OsubuDc/Thesis/README.md

# Thesis
Adaptive impedance control of a 1-DoF series elastic actuator in contact-rich tasks using reinforcement learning.
