OsubuDc/Thesis/VSCODE_LaTex/main.tex

\documentclass{article}

\usepackage[
  backend=biber,
  style=ieee
]{biblatex}

\addbibresource{/home/oskar/Thesis/VSCODE_LaTex/ThesisReferences.bib} % relatieve pad

\begin{document}

Hier citeer ik de paper van Shim \cite{shimDisturbanceObserver2020}.

\printbibliography

\end{document}
