OsubuDc/Thesis/ThesisV2/ThesisV2_main.pdf

KU Leuven

Faculty of Engineering Technology

# Implementation of a novel compliant

# transmission in a 3 DoF robotic

# testbench for collaborative hand

# guiding tasks

## Oskar De Clerck

A thesis submitted for the degree of Master of Science in industriële wetenschappen: Elektromechanica

Academic Year 2025–2026

Promotor: ir. Maurizio Grossi Copromotor: prof. dr. ir. Dino Accoto

# Abstract

i

ii

# Acknowledgements

iii

iv

# Contents

Abstract | i
Acknowledgements | iii
Nomenclature | xi
1 Introduction | 1
2 Literature Review | 11
3 Methodology | 25

v

Contents

4 Validation and Results | 27
5 Conclusion and Future Work | 29
References | 31
2D Manufacturing Drawings | 35
Additional Experimental Results | 37
Source Code | 39

vi

# List of Figures

1.1 Human, robot, and shared workspace from Fraunhofer [6] | | 3
1.2 Levels of cooperation between human worker and robot from Fraunhofer [6]. . | 3
1.3 3ARM manipulator [19] | | 7
1.4 Gas spring characteristic by Suspa [20] | | 7
1.5 Spring balancer from Transprotec [21] | | 8
1.6 IAD integrated in an assembly line [24] | | 8
2.1 Impedance control for robotic structure in contact with an environment [25]. | 12
2.2 Mass–spring–damper system in contact with external force fe [25] | | 12
2.3 General classification of the impedance control approaches [25] | | 13

2.4 Impedance control diagram, with reference position xr, external force fr which
in theory can be canceled, and a measured position x [25] | 15

2.5 Admittance control diagram, with reference position xr, compliant reference
position xc, measured position x, and measured external force fe [25] | | 15
2.6 Mass–spring–damper system with commanded position xc [25] | | 17
2.7 Motor and load connected with a rigid shaft | | 18
2.8 Motor and load connected with a compliant coupling | | 18
2.9 General SEA schematic reconstructed from [29] | | 19
2.10 Vector diagram reconstructed from [29] | | 22
2.11 Torque control diagram with feedforward terms from [29] | | 23
2.12 Torque control diagram from [30] | | 24

vii

List of Figures

viii

# List of Tables

4.1 Example results table | 27

ix

List of Tables

x

# Nomenclature

## Symbols

q | Joint position vector | [rad]
Ks | Spring stiffness | [Nm/rad]

## Abbreviations

CAN | Controller Area Network
SET | Series Elastic Transmission

xi

List of Tables

xii

# Chapter 1

# Introduction

## 1.1 Background and Motivation

### 1.1.1 Musculoskeletal disorders and ergonomic work environments

Non-ergonomic work environments place strain on the human body, which can cause painful complications and limit the worker’s ability to perform tasks optimally. Ergonomics can be defined as the study of work, where the goal is to fit tasks and jobs to workers’ capabilities, rather than forcing workers to adapt to the job. An ergonomic work environment therefore implements task-specific strategies to prevent reduced work ability. How these complications arise, which parts of the body are affected, and how they can be prevented are explained in this section.
The musculoskeletal system contains muscles, bones, joints and connective tissues like tendons and ligaments. Musculoskeletal disorders (MSDs) can therefore be defined as injuries of the

muscles, nerves, tendons, joints, cartilage, and spinal discs. When these injuries are sustained or worsened by exposure to risk factors in the workplace, they are also known as work-related musculoskeletal disorders (WMSDs). These disorders can go from minor aches to severe

pain and chronic illness requiring medical treatment, potentially preventing workers from performing physical tasks.
WMSDs develop over time due to non-ergonomic working conditions and can be categorized into two main groups:
- Back disorders related to handling loads
- Upper limb disorders, also known as repetitive strain injuries (RSIs)

MSDs can be caused by, for example:

- Twisting and bending movements while handling loads
- Repetitive or forceful movements
- Awkward and static postures
- Exposure to vibrating tools
- Prolonged sitting or standing in the same position

Chapter 1. Introduction

An increase in MSDs has been reported worldwide. This rise is partly attributed to improved recognition and reporting, but also to the tendency for work to be more segmented and specialized. This trend is driven by an increasingly competitive global economy, where fast-paced repetitive work environments are more widespread.

### 1.1.2 Industrial motivation for ergonomic improvement

Musculoskeletal disorders affect approximately one in three people worldwide. Within the European Union, MSDs represent the most costly health-related problems, affecting 45 million workers. Many individuals are unable to continue working beyond the age of 60 due to these conditions, resulting in billions of euros in lost revenue and a substantial burden on the public healthcare system.

A declining physical condition can also lead to mental health issues such as depression or frustration, resulting in reduced job satisfaction and, indirectly, lower work performance, even when workers are still physically able to continue working.

The increase in education in the workforce, combined with higher expectations regarding job satisfaction, has reduced workers’ tolerance for WMSDs. An ergonomic work environment can prevent the development of WMSDs and directly reduce both the cost to companies due to sick leave and the societal impact.

Reduced work ability can be categorized into absenteeism and presenteeism. Absenteeism refers to the absence from work due to injuries sustained on the job. Presenteeism describes the situation in which workers continue to attend their expected work duties despite existing injuries, often due to concerns about job security. In such cases, work is performed in a self–protective manner to reduce physical strain.

In Belgium, 2.5 million people were affected by MSDs in 2018 (approximately 62% of the Belgian working population in 2015), resulting in 3 billion euros in direct medical costs and 2 billion in work absenteeism, corresponding to 0.3% of Belgium’s gross domestic product [1][2][3][4][5].

### 1.1.3 Physical human–robot interaction

There is a clear need to address reduced work efficiency resulting from physical injuries since this improves the quality of life of an increasingly older workforce, while also reducing the impact on social welfare systems and increasing overall economic productivity. Industry has already adopted robotic solutions to achieve accuracy, speed, and repeatability that human workers cannot provide. Humans, however, provide flexibility and have the capability to react to unforeseen circumstances. By increasing the degree of human participation, the strength and repeatability of robots are combined with the adaptability and decision–making skills of humans. Humans and robots each operate in their respective workspaces to perform their tasks, and in some cases share the same workspace, as illustrated in Figure 1.1.

1.1. Background and Motivation


Figure 1.1: Human, robot, and shared workspace from Fraunhofer [6].

Human–robot cooperation generally refers to the use of robots without safety fencing, also called cage–free robots. This is in contrast to traditional robots which are stiff, heavy, and lack safety features that allow them to operate in the same space as humans, and are consequently only allowed to operate in closed –off workspaces.

Humans and robots can work together in different types of operation, as illustrated in Figure 1.2.


Figure 1.2: Levels of cooperation between human worker and robot from Fraunhofer [6].

From left to right an increasing level of interaction is shown.

- Cell: Robot operates in traditional cage, fenced–off from human contact
- Coexistence: Human and cage–free robot work at the same time, but in different workspaces
- Synchronized: Humans and cage–free robots work in the same workspace, but one at a time
- Cooperation: Human and cage–free robot have tasks in the same workspace at the same time, but do not work together on the same task

Chapter 1. Introduction

- Collaboration: Human and cage–free robot work in the same workspace on the same task

The robotic testbench developed in this thesis operates in collaboration mode during assisted load handling, when the human operator physically guides the robotic arm, and in coexistence mode during the floating stand–by state, when no physical interaction is taking place. This distinction is further clarified in chapter (idk exactly for now).

Collaborative robots, defined as robots capable of performing collaborative tasks as described above, are widely used in industry. However, they are still primarily applied in traditional robotic operations such as pick–and–place tasks. In many cases, humans and robots remain either physically separated or operate in a coexistence mode, where no physical barrier is present but no direct interaction takes place. Such implementations are only economically viable for large batch sizes, since a whole production line needs to be tuned towards that specific robotic solution.
Cage–free robotic arms that share a workspace with a human worker are introduced to increase production flexibility. Interactive robotic solutions for small batches and varying product sizes have become a clear need since 70% of collaboration between human workers and robots occurs in assembly applications. An industry survey reported that 86% of respondents were willing

to invest in robotic solutions, indicating strong industrial interest. The primary motivations for introducing robotic arms in assembly environments are:

- Improving operational efficiency
- Improving ergonomics

Cage–free robotic solutions generally involve higher initial costs compared to traditional fenced systems due to safety certification requirements and conformity procedures to minimize the risk of injuries. However, companies are often willing to accept longer payback periods for implementing and testing company–specific robotic solutions which increase ergonomics [6][7]. ISO/TS 15066 covers the safety requirements for collaborative operations between human

workers and robots. This normative classifies four different collaborative operations modes [8][9]:

- Safety–rated monitored stop
- Hand guiding
- Power and force limiting
- Speed and separation monitoring

Safety–rated monitored stop

The robot operates at its rated speed when a human is not present in the collaborative workspace. When a human enters the workspace, which can be detected by various means like laser scanners or light curtains, the robot undergoes a complete stop. As long as the human is in the workspace, the robot will not operate. Only by leaving the workspace and resetting the safety stop, can operation continue.

1.1. Background and Motivation

Hand guiding

Hand guided robotic applications are defined as a direct physical interaction between humans and robots, where the human operator has full control over the robot’s motion. In this approach, a direct input device is located at or near the end–effector to measure input forces and simultaneously define the position of the human in the shared workspace. The robot must be in a monitored stop before hand guiding can be activated via an enabling device. Safety requirements for this mode include force and/or torque sensing at the guiding point,

emergency stop accessible from the position where the robot is being guided, which is typically at the end–effector, and a maximum speed limit during guided motion.

Power and force limiting

This mode is the most commonly associated with collaborative robots. The robot’s software and hardware are designed in such a way that any contact with a human cannot result in injury. Low robot mass, rounded surfaces, and padding are combined with active force and torque sensing, which limits contact forces with the environment below defined thresholds depending on the body region of the human that can be in contact with the robot.

Speed and separation monitoring

Robots and humans can operate in the same workspace at the same time, but the position and speed of the human and robot relative to each other is constantly monitored to adjust the speed of the robot with the goal of constantly having a minimum dynamical separation distance at all times.

Hand guiding is useful for packaging and assembly applications since it combines the physical strength of robotic arms, which can compensate for the weight of components or help with move relatively light but large components, with human intelligence.
ISO/TS 15066 specifies that the hand–guiding devices should be located at or near the robot

end–effector, structurally restricting compliant interaction to a single designated contact point. Collisions or attempted handling of the robotic arm elsewhere will result in a safety stop [10].

Existing robotic solutions that allow a human worker to hand guide a robotic arm while simultaneously identifying and compensating for payloads of unknown variable weights, without requiring prior software configuration, are to the best of the author’s knowledge, not available in assembly and packaging industries. When hand guiding is discussed in literature, it is typically limited to sensorized end–effectors on conventional stiff robots. Collaborative robots adopted in industry generally lack build–in compliance. As previously stated, collaborative robots are used for applications with little to no human contact, where precision and repeatability is more important than inherent compliance [11][12].

This absence in current industrial applications is further supported by surveys of end users, system integrators and researchers, which indicate that collaborative robots are still primarily used as conventional stiff robots with limited or no direct human interaction, while offering the added value of less space requirements for operation [13].

Chapter 1. Introduction

Current collaborative robots with the highest payloads, such as the UR30 from Universal Robots and the CR-35iB from FANUC, can handle loads up to 30kg and 50kg respectively. Still, hand guiding is mainly used for point– and path–based teaching and not for weight compensation tasks in hand guiding applications. The user can intuitively move the robot to a new point in space and record that position. This can be done for a single point or for a full path; in this case the robot records the continuous movement while a button is pressed. It is, however, possible to correctly configure collaborative robots for weight compensation, but software is required for correct calibration of the load attached to the end–effector. Although rare, some collaborative robots can estimate payload weight and center of mass by performing predefined controlled motions, but multiple interactions with the software controller are needed, making this approach time–consuming. This method is not generally available, and is often part of an optional software package that is not compatible with every collaborative robot. This confirms that automatic real–time payload identification without software interaction is not a standard feature of current collaborative platforms deployed in assembly and packaging contexts industries, representing a key limitation addressed by this thesis [14][15][16][17].

### 1.1.4 Weight assisting devices

Passive weight compensating manipulators are well established in industrial environments to help human workers perform their tasks in a more ergonomically sustainable way. These devices, if well calibrated, allow payloads to be moved around with minimal effort, offering passive, purely mechanically sourced weight compensation, effectively combining software–free and intuitive use. These manipulators however share a fundamental limitation; they only operate efficiently only within a pre-tuned weight range. The further a payload differs from the equilibrium point, the more force the human operator will have to deliver to move the load fixed to the manipulator. As a direct consequence, varying payloads that are too different in weight cannot be manipulated with these devices without manually re–tuning the counter–force system, for example counterweights and gas springs [18]. The proposed system replicates the

intuitive, software–free interaction properties of a passive balancer, while adding real–time load identification and the possibility to perform autonomous tasks, integrating this solution into the production line. Some commercially available examples support this claim.

1.1. Background and Motivation

The company 3ARM produces commercially available weight compensating manipulators, an example of which shown in Figure 1.3. Pneumatic gas springs are used to compensate weights within a minimum and maximum payload limit. The gas springs can be manually tuned to compensate for different weight classes [19]. Figure 1.4 presents an example of a gas

spring characteristic. By adjusting the filling pressure, the spring can optimized for different payloads scenarios [20].

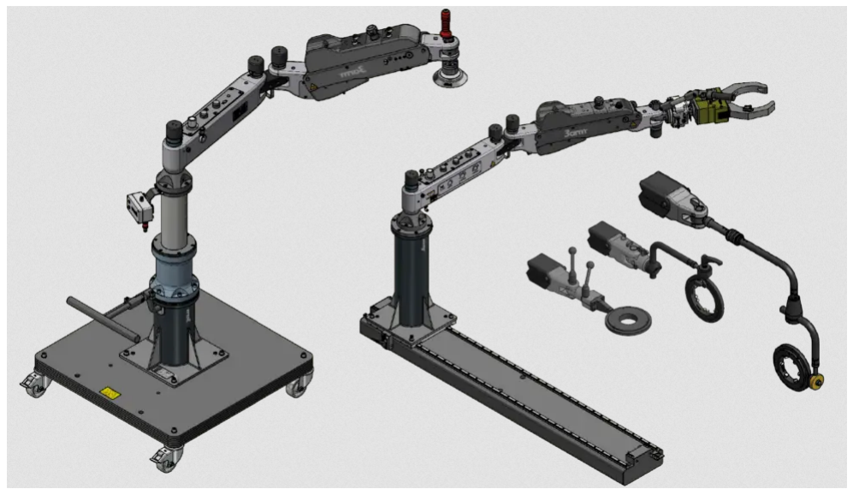
[picture p92: figure]

Figure 1.3: 3ARM manipulator [19].


Figure 1.4: Gas spring characteristic by Suspa [20].

Chapter 1. Introduction

Transprotec offers spring balancers, showh in Figure 1.6, that are tuned to a specific weight, load changes are not permitted to guarantee safety and correct operation [21].

Figure 1.5: Spring balancer from Transprotec [21].

### 1.1.5 Intelligent Assist Devices

The robotic testbench proposed in this thesis belongs to the category of Intelligent Assist Devices (IADs). These are described as computer–controlled, servo–driven tools that enable

human workers to manipulate payloads in a safe and ergonomic way. This differentiates IADs from the devices described in Section 1.1.4, which were completely passive. IADs were

introduced to increase productivity and mitigate non–ergonomic work environments, a major issue in societies with an aging workforce. Currently, the term IADs is not commonly used anymore, as it has been subsumed under the modern term collaborative robots [22]. When

IADs are mentioned today, they primarily appear as overhead gantry–mounted installations. While IADs can be effective in dedicated production cells with sufficient overhead clearance, they are unsuitable for industrial environments where ceiling height is limited, or overhead obstructions are present.
IADs cannot only interact safely and compliantly with human operators, but can also actively follow a predefined path. An example of this semi–autonomous strategy can be found in the

automotive industry, where the controller guides the payload along a moving assembly line so that the human operator can focus on correctly installing the part into the assembly, rather than continuously repositioning the payload, as shown in Figure 1.6[23][24].

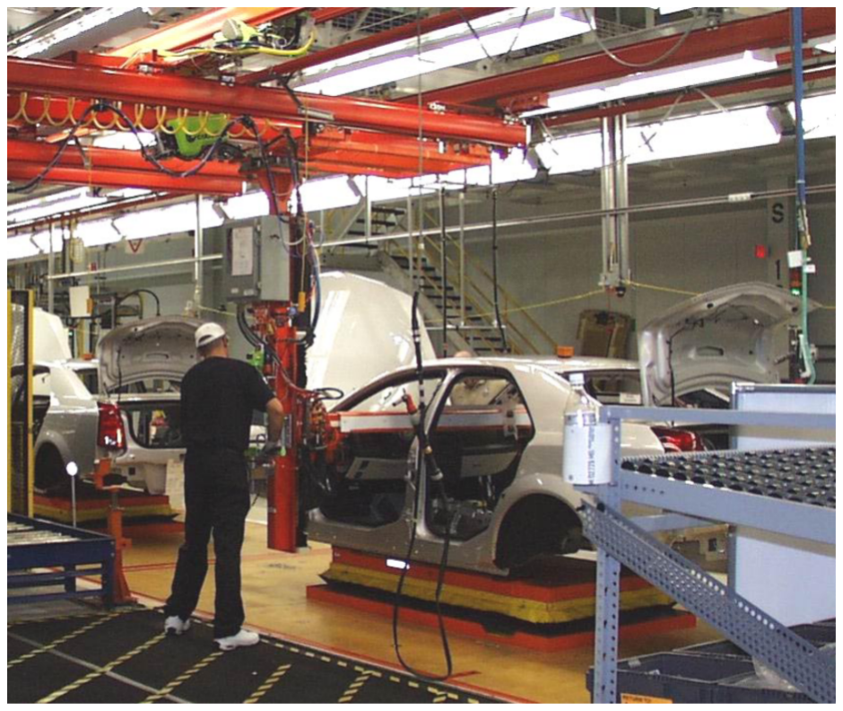
[picture p93: figure]

Figure 1.6: IAD integrated in an assembly line [24].

1.2. Problem Statement

## 1.2 Problem Statement

Non–ergonomic load handling is the primary cause of musculoskeletal disorders in packaging and assembly industries. Passive weight compensating devices are well established in industry with the goal of reducing this physical strain on the human body; these devices however cannot adapt to varying payloads and provide no sensing, intelligence, or active integration with production lines.
Intelligent assist devices offer semi–autonomous advantages to support payload manipulation. Gantry–style implementation cannot be used in buildings with limited ceiling heights or overhead obstructions. IADs are semi–autonomous solutions and can thus offer a higher degree of integration than passive devices.
Collaborative robots require frequent software interaction to calibrate the system for different payloads or work modes. Although rare, it is possible for specific collaborative robots to go through predefined motions to estimate the weight of a payload rigidly attached to the end–effector, which also requires software programming and confirmation. Payloads also need to be fixed to the end–effector, which is not always possible for loads that vary in shape and size.
This thesis presents a three degree of freedom robotic testbench using novel, inherently compliant transmissions. This allows for the combination of an intrinsically safe design with real–time weight measurements and intuitive, software–free hand guidance at any point along the arm structure. This approach aims to combines the strengths of collaborative robots with passive or intelligent assist devices.
The testbench provides a weight–optimized platform that allows for further validation of the novel transmission, offering data acquisition and a configurable controller written in C++ specifically for the approach of this thesis.

## 1.3 Thesis Outline

In Chapter 2, the theoretical background on concepts relevant to this thesis is introduced, followed by an overview of the current state of the art in collaborative load–handling systems.

In Chapter 3, the design of the robotic testbench is presented; this includes the mechanical design, hardware implementation, proposed controller, and data communication architecture.

In Chapter 4, the developed testbench and proposed controller are experimentally validated; this includes mechanical design validation and controller performance evaluation in interactive load–handling experiments.

Chapter 5 summarizes the main conclusions of this thesis, discusses limitations of the proposed system, and presents possible improvements for future development.

Chapter 1. Introduction

# Chapter 2

# Literature Review

## 2.1 Theoretical Background

### 2.1.1 Impedance control

Impedance control is widely used in applications that involve physical human–robot interaction. The interaction forces between the robotic structure and its environment can be regulated by adjusting the apparent mechanical impedance of the robot. Mechanical impedance is defined as the ratio of the output force to the input velocity. It represents how much the robotic structure resists motion when an external force is applied.

Z(s) = F(s)
v(s)

(2.1)

Its inverse, mechanical admittance is defined as the ratio of input velocity to the output force.

Y (s) = v(s)
F(s)

=

1
Z(s)

(2.2)

When two mechanical bodies interact, the interaction can be characterized by their relative mechanical properties. A body that resists motion by responding to displacement with forces is modelled as a mechanical impedance. A body that responds to forces by generating motion or deformation is modelled as a mechanical admittance. These roles are not inherent properties of the objects themselves, but a consequence of the mechanical properties of the interacting bodies relative to each other, and the choice of input and output signals.
In conventional robotic applications, the robotic structure is stiff, position–controlled, and has a high inertia compared to its environment, like a human worker or payloads. It follows a defined trajectory and resists external forces; in this scenario, the robotic structure behaves as an impedance. The environment, whether it is a workpiece, or a human worker, yields to externally applied forces and is typically modelled as an admittance. As an example, pushing a trolley or compressing a pillow by applying an external force can clarify this concept; in both cases the environment moves or deforms in response to an applied force.
The impedance or admittance assignment is context–dependent. A rigid concrete wall presents an impedance that is much higher than that of a lightweight robotic structure; from the perspective of the robotic structure, it must yield to its much stiffer environment.

Chapter 2. Literature Review

A human operator physically guiding a robotic arm applies forces and expects the robotic

structure to move; the human worker behaves like an impedance, while the robotic structure behaves like an admittance. Impedance control modifies the mechanical impedance of a robotic structure to control how it behaves relative to its environment.

Figure 2.1 illustrates a stiff robotic structure interacting with its environment. The schematic at the end–effector demonstrates how impedance control can modify the apparent impedance.


Figure 2.1: Impedance control for robotic structure in contact with an environment [25].

Impedance control mirrors the ability of the human body to change its mechanical impedance by tensioning its muscles. To guarantee safe interaction between a robotic structure and its environment, one of the two bodies should be compliant relative to the other. Most collaborative robots lack the ability to dynamically change their mechanical impedance; therefore, safe interaction between between a robot and an unknown environment cannot be guaranteed by mechanical design alone. Impedance control allows for a user–defined, dynamic relationship between the trajectory of the end–effector and the contact forces from the environment, allowing stiff robotic structures to compliantly react to their environment.


Figure 2.2: Mass–spring–damper system in contact with external force fe [25].

The mathematical derivation for impedance control starts by considering a second–order system as shown in Figure 2.2.

m x¨ + b x˙ + k x = u + fe | (2.3)

In this equation, m represents the system mass, b the damping coefficient, k the stiffness coefficient, u the control input (as seen from the plant’s perspective) generated by the controller

which is applied to the plant dynamics, and fe is the external force applied to the system.

2.1. Theoretical Background

The position x = xe represents the position of the contact surface and can be interpreted as the position error relative to the equilibrium position xr.
As stated before, the idea of impedance control is to change the apparent impedance of a mechanical system. By defining a target impedance, the mechanical impedance of the system can be modified. This target impedance is expressed as a virtual mass–spring–damper system:
md (ẍ − x¨r) + bd ( ẋ − x˙ r) + kd (x − xr) = fe, | (2.4)

In this equation, md, bd, and kd respectively represent the desired inertia, damping, and stiffness of the system. A lower kd makes the robotic structure more compliant, while a higher kd makes it stiffer. The damping bd opposes velocity and influences how fast the system will settle. The inertia md determines the system’s resistance to acceleration.
A general classification of impedance control approaches is shown in Figure 2.3. The conventional approaches are discussed in this thesis, as these provide a sufficient conceptual understanding of the topic [25]–[28].


Figure 2.3: General classification of the impedance control approaches [25].

Force–based impedance control

In force–based impedance control, the control input u is a force or torque generated by the controller and is applied to the plant. Consequently, the motor drivers should be able to directly control their output torque; motor drivers only capable of position or velocity control cannot directly implement an impedance controller.
The control law is derived by requiring that the system satisfies the target impedance of Equation (2.4). In the first step, the plant dynamics (2.3) are solved for the system’s

acceleration term x¨:
x¨ =

1
m

u + fe − b x˙ − k x
. | (2.5)

The target impedance (2.4) is solved for the desired acceleration x¨:

x¨ = ẍr + m⁻¹
d
fe − bd ( ẋ − x˙ r) − kd (x − xr)
. | (2.6)

Chapter 2. Literature Review

For the system to satisfy the desired impedance behaviour, the actual acceleration (2.5) and the desired acceleration (2.6) must equal each other.

1
m

u + fe − b x˙ − k x

= ẍr + m⁻¹
d
fe − bd ( ẋ − x˙ r) − kd (x − xr)
. | (2.7)

Multiplying both sides by m and solving for u:

u = b x˙ + k x − fe + m x¨r + m m⁻¹
d
fe − bd x˙ + bd x˙ r − kd x + kd xr
. | (2.8)

Collecting terms in x˙, x, and fe gives the force–based impedance control law as presented in Equation (2.9).

u =

b−m m⁻¹
d

bd

x˙ +

k−m m⁻¹
d

kd

x−

1−m m⁻¹
d

fe+m m⁻¹
d
bd x˙ r+kd xr+md x¨r
. (2.9)

When desired inertia md equals the actual inertia m, the inertia ratio m m⁻¹
d

becomes unity.
This results in the external force term fe being canceled, and Equation (2.9) simplifies to:
u = (b − bd) ẋ + (k − kd) x + bd x˙ r + kd xr + m x¨r. | (2.10)

The elimination of fe from the control law holds only when m = md exactly. In practice, the effective inertia of a robotic structure cannot be perfectly matched by a fixed nominal value, resulting in behaviour that does not fully conform to the simplified control law. Since the term representing the external force has been canceled, no force sensor is required. This formulation represents a velocity and position feedback with feed–forward desired trajectory values.

An important limitation of this approach is that contact force is only controlled indirectly by specifying a reference position. For example, for a rigid robotic structure in free space, the stiffness k is considered 0 N m⁻¹ and the desired spring constant kd is set to 500 N m⁻¹
. If a
contact force of 10 N is desired, the deviation from the reference position must be exactly 20 mm. This cannot be guaranteed unless the physical properties and position of the environment are exactly known, which is not always feasible. As a consequence, impedance control can either guarantee accurate position tracking or force tracking. A stiff value for kd will produce high forces for small position errors resulting in accurate position tracking. A soft spring will result in accurate force control, but with large position errors as a trade–off. A diagram of impedance control is shown in Figure 2.4. Note that only a reference position is used; whether reference velocity and acceleration are also considered depends on the application and the available measurements [25]–[28].

2.1. Theoretical Background

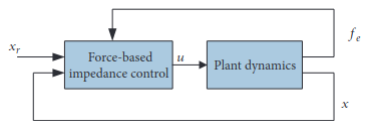
[picture p94: figure]

Figure 2.4: Impedance control diagram, with reference position xr, external force fr which in theory can be canceled, and a measured position x [25].

Position–based impedance control

Position–based impedance control is commonly referred to as admittance control, and is, as previously stated, the inverse of impedance control which was discussed above. Where impedance control reacts to motion deviation by generating forces, admittance control reacts to forces by deviating from the desired motion. Contrary to impedance control, a force measurement is required, meaning that sensors need to be fitted to the contact point with the environment.
A position–based impedance controller consists of two control loops as shown in Figure 2.5. The outer loop imposes the desired target impedance by generating a commanded reference position xc, the inner position loop tracks that compliant reference position generated by the outer loop.

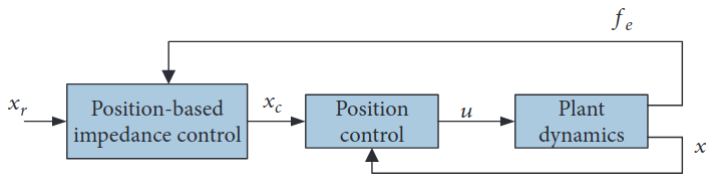
[picture p95: figure]

Figure 2.5: Admittance control diagram, with reference position xr, compliant reference position xc, measured position x, and measured external force fe [25].

The outer loop requires both the reference position xr and the measured external force fe as input to compute the value for xc as shown in Equation (2.11), where xc is the only unknown

variable.
md (ẍc − x¨r) + bd ( ẋc − x˙ r) + kd (xc − xr) = fe. | (2.11)

When no external force is measured (fe = 0 N), the commanded impedance reference position xc must equal xr. When the external force fe = 0 ̸ , xc deviates from xr according to the

desired impedance parameters md, kd, and bd. For example, when an external force fe = 10 N is applied and kd = 500 N m⁻¹
, ignoring the velocity and acceleration terms at steady–state, a deviation of xc − xr = 20 mm is calculated.

This commanded position is used as the input for the inner loop, which can be a conventional position controller such as a proportional–derivative (PD) controller as shown in Equation (2.12), which tracks the commanded trajectory xc.

u = kp (xc − x) + kv ( ẋc − x˙), | (2.12)

The inner loop has no knowledge of the desired impedance behaviour, its only purpose is

Chapter 2. Literature Review

to track the commanded position as accurate as possible. Therefore it must be sufficiently stiff in order for the admittance controller to work as intended. If the position control loop is compliant, the actual robot position will not accurately follow xc. Consequently, the impedance felt by the operator becomes a combination of the outer impedance loop and the inner position loop, possibly creating unsafe behaviour [25]–[28].

Position–based versus velocity–based inner loop

The inner loop can track either a commanded position xc or a commanded velocity x˙ c. This choice depends on the application, which can be illustrated by considering a step force applied to the robotic structure by the human operator. In collaborative load handling, there is no spring that pulls the robot arm back to a static reference position. The human operator moves the robotic structure freely and expects it to stay wherever it is released, instead of pulling back. Therefore, in this example, the desired spring constant kd = 0 N m⁻¹
to ensure that the
robotic structure to not pull back against the force applied by the operator. To illustrate the difference between a position inner loop and a velocity inner loop, consider Equation (2.11),

simplified by setting the desired inertia term md and reference velocity x˙ r to zero.

bd x˙ c = fe | (2.13)

The step force applied by the human operator fe is constant after t = 0⁺, resulting in

Equation (2.14) and (2.15).
bd x˙ c = 1 | (2.14)
x˙ c = 1/bd | (2.15)

A constant force will result in a constant velocity xċ. Consequently, the commanded reference position xc grows linearly over time. This behaviour results from the absence of the virtual spring which would create an equilibrium position. With a position–based inner loop, the controller tries to track this continuously growing commanded position, meaning that any lag in the inner loop can cause accumulation of the tracking error. Therefore, this approach requires aggressive tuning, which is more prone to instability issues.

With a velocity–based inner loop, the controller tracks a commanded reference velocity xċ instead. Since xċ is constant for the theoretical step force applied by the operator, the controller tries to match a constant velocity instead of a continuously growing position. This approach allows for less aggressive tuning, and thus a more stable controller.

The mass–spring–damper system with the commanded trajectory xc is shown in Figure 2.6. The admittance controller combines the measured force fe with the reference position xr. When the robotic structure should remain in continuous contact with the environment, such as in grinding applications, xr can be set slightly beyond the contact surface to maintain a constant contact force [25]–[28].

2.1. Theoretical Background


Figure 2.6: Mass–spring–damper system with commanded position xc [25].

Comparison of Force-Based and Position-Based Impedance Control

Force–based impedance control commands torques directly and does not require an inner control loop. It can operate without a force sensor when the desired inertia is set equal to the actual inertia. To achieve stiff behaviour, high values for the impedance parameters must be chosen, amplifying the sensor noise which can result in instabilities. As was stated before, either the environment or the robotic structure should be compliant. If the environment is stiff, the robotic structure must feel soft, meaning lower values for the impedance parameters can be chosen resulting in less sensor noise amplification.
Admittance control requires both a force sensor and a stiff inner control loop. It is consequently better suited for stiff behaviour against compliant environments, such as a human operator. The performance depends on the quality of the inner loop and the force measurement. Most industrial manipulators are equipped motor drivers with integrated position controllers, and since admittance control uses an inner position loop, it can be implemented without redesigning the low-level control architecture [25]–[28].

Chapter 2. Literature Review

### 2.1.2 Series elastic actuator

In conventional machine design, the interface between a motor and its load is made as stiff as possible. As discussed previously, robotic systems are still predominantly used for position-control tasks, where high structural stiffness is beneficial. A stiff structure improves position accuracy, stability, and bandwidth for position control.

When only the motor position is measured, a stiff structure minimises the position error between the motor shaft and the endpoint. For example, if a motor is connected to a rigid shaft as shown in Figure 2.7, the angular position of the endpoint can be accurately represented by the motor encoder reading. When this shaft is replaced by a compliant component such as a rubber coupling, as shown in Figure 2.8, the motor encoder no longer accurately reflects the angular position of the endpoint.

Figure 2.7: Motor and load connected with a rigid shaft.

Figure 2.8: Motor and load connected with a compliant coupling.

When the position sensor is placed after the elastic coupling, the elasticity becomes part of the feedback loop. The motor and load inertia are coupled through the elastic element, and a stiffer coupling increases the resonance frequency of the system, allowing a higher control bandwidth:

ωn =

s
k

1
Jm

+

1
Jl
(2.16)

Most electric motors have poor torque density: they can only achieve high power output at high rotational speeds. Since mechanical power is the product of torque and angular velocity.

P = τ · ω | (2.17)

A lightweight, high-speed motor requires a transmission to deliver useful torque at the low speeds typical of robotic joints. Unfortunately, gears introduce significant drawbacks such as backlash, friction, torque ripple, and reflected inertia. For a gear ratio of N:1, the reflected inertia at the output is

Jreflected = Jmotor · N

2
| (2.18)

This N² amplification means that shock loads on the output shaft produce very high forces

on the gear teeth, and it is often the load rating of the gears that limits the allowable output torque. The high reflected inertia also makes the actuator difficult to backdrive, which is problematic for force control and safe interaction with unknown environments. Because of low

2.1. Theoretical Background

torque density servo motors with a power rating much higher than the useful power output must be selected, resulting in expensive and oversized designs.

The series elastic concept

A solution to these problems was introduced by Pratt and Williamson, who proposed the Series Elastic Actuator (SEA). As the name describes, an elastic element is placed in series

between the transmission output and the load, as illustrated in Figure 2.9.

Figure 2.9: General SEA schematic reconstructed from [29].

The spring obeys Hooke’s law,
F = k · δx | (2.19)

so by measuring the spring deflection δx and knowing the spring constant k, the force

transmitted to the load can be calculated directly.

Masuring force through a stiff transmission is inherently difficult; friction, backlash, and torque ripple influence the relationship between motor current and output force. The series elastic element resolves this by converting the force measurement into a displacement measurement. The output force is determined by the spring deflection, which is a position that can be measured accurately regardless of the transmission’s non–linearities. The motor receives a torque command, but the feedback signal that signals the controller whether the output force is correct is the spring deflection which is a position measurement. In this way, the force sensing problem is transformed into a position sensing problem. A force control problem consequently becomes a position control problem, which is the strength of motor equiped with a transmission.

Benefits of series elasticity

The spring acts as a mechanical low-pass filter on shock loads. When the output is subjected to a sudden impact, the spring deflects and spreads the impulse over a longer duration, reducing the peak forces on the gear teeth. Only the output–side mass contributes to the initial impact, the reflected inertia N²Jmotor is decoupled from the output by the spring. The lengthened

impulse also gives the control system more time to accelerate the motor inertia and respond to the external force.

In a stiff actuator with force feedback, even a small displacement generates a large force reading. A high–gain feedback controller would respond aggressively, pulling back and causing the force to drop suddenly, resulting in chatter between the actuator and the load. To avoid this, the controller gains must be kept low, resulting in a slow system that is unable to respond to small forces.

Chapter 2. Literature Review

With the introduction of a compliant element a moderate displacement generates a small force reading. This allows higher control gains without risking instability. At frequencies within the control bandwidth, the force–feedback loop can effectively cancel the spring force entirely, creating the behaviour of a zero-rate spring (an infinite compliant spring). From Equation (2.16), it is clear that when k = 0 N m⁻¹
, the resonance frequency ωn = 0 rad s

−1
Since motor and load inertias cannot resonate with a zero–rate spring, the system is inherently stable when interacting with any passive object.

At high frequencies, the impedance of a traditional stiff actuator is dominated by its inertia, while a SEA presents the impedance of the spring, which is safer for interactions with unknown environments. However, since the high–frequency impedance of the SEA is governed by the spring, a light load can potentially resonate with it. Since the physical robotic structure has a mass, the resonant frequency of the system is lowered into te range where the control loop operates effectively thus being able to control apparent impedance of the system.

Because the force output of a SEA depends on the motor shaft position rather than the motor’s internal torque, the transmission’s non–linearities (such as friction, backlash, and torque ripple) do not directly affect the force measurement. These non–linearities affect the

motor effort required to achieve a given shaft position, but since the force is measured via the spring deflection and incorporated in the feedback loop, the controller commands the correct motor motion regardless. This allows the use of less expensive gears and motors without sacrificing force–control quality.

Performance limits

The performance limits of a series elastic actuator can be understood by decomposing the required motor force. Consider the system shown in Figure ??, where a motor with mass Mm is connected to the load through a spring with stiffness ks.

The spring force on the load is given by Hooke’s law:

Fl = ks(xm − xl) | (2.20)

where xm is the motor position and xl

is the load position. Newton’s second law for the motor gives the net force to accelerate the motor mass:

Mmx¨m = Fm − Fl | (2.21)

Rearranging:
Fm = Fl + Mmx¨m | (2.22)

The motor position can be expressed in terms of the load position and the spring force by rearranging Equation (2.20):

xm = xl +

Fl ks | (2.23)

2.1. Theoretical Background

Differentiating twice:

x¨m = ẍl +

F¨
l
ks

(2.24)

Substituting into Equation (2.22):

Fm = Fl + Mmx¨l +

Mm
ks

F¨
| l | (2.25)

To analyze the system in the frequency domain, sinusoidal steady–state signals are assumed. Any sinusoidal signal can be represented using a complex exponential of the form:

x(t) = ˆxejωt, | F(t) = F ê jωt | (2.26)

where xˆ and Fˆ are complex amplitudes and ω is the angular frequency.

Using the complex exponential form allows derivatives to be computed easily. In particular, differentiating e

jωt results in multiplication by jω, and the second derivative results in

multiplication by −ω

2

d
dte
jωt = jωejωt , | d
| 2
| dt² e jωt = −ω
| 2
e
jωt | (2.27)

Therefore, the second derivatives can be replaced as:

x¨ → −ω

2x, | F¨ → −ω
| 2F | (2.28)

Applying these substitutions to Equation (2.25) gives:

Fm = Fl −

Mmω

2

ks

Fl − Mmω

2xl | (2.29)

The three terms have the following physical interpretation:

1. FL: Fl

is the force applied to the load coming from the spring.

2. Fms:

Mmω

2

ks

Fl

is force used to accelerate the motor mass, which in turn will cause

spring deformation. This term is unique to the SEA.

3. Fmi: Mmω

2Xl
is the force required to accelerate the motor mass to track a moving load. This term exist regardless of the presence of a series spring.

The force that is required by the motor is limited to Fmax, which in practise can be a limit on the motor current to prevent overheating for example.

|Fm| ≤ Fmax | (2.30)

The motor force constraint |Fm| ≤ Fmax can be visualised as a vector diagram (Figure 2.10).

The vector Fm is the sum of three components, and its magnitude must stay inside a circle of radius Fmax.

Chapter 2. Literature Review

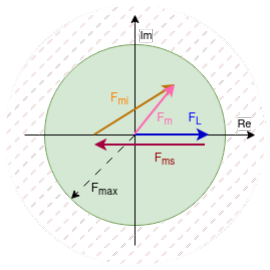
[picture p96: figure]

Figure 2.10: Vector diagram reconstructed from [29].

Fl

is arbitrarely aligned with the real axis. The second component (the SEA term) points in

the opposite direction along the real axis, moving the starting point of the third vector to Fl(1 − Mmω

2/Ks). From this new starting point, the third component (−Mmω

2Xl) extends

in the direction determined by the phase relationship between force and load motion. The final sum gives Fm.
The series elasticity is beneficial for all frequencies ω < q
2

ks
Mm

given by Equation (2.33), since

the vector Fm gets smaller. The actuator can handle faster or larger load motions before saturating at Fmax.

1 −

Mmω

2

ks

< 1 | (2.31)

Expanding the absolute value inequality:

−1 < 1 −

Mmω

2

ks

< 1 | (2.32)

The right–hand side gives Mmω

2
ks

≥ 0, which is always satisfied since Mm > 0, ks > 0, and

ω

2 ≥ 0. The left–hand side gives:

Mmω

2

ks

< 2 | =⇒ | ω < s
2ks
Mm

(2.33)

The series elasticity improves or limits performance depends on the task. When the output force varies, the motor must move to change the spring deflection, and the motor’s inertia and torque limits restrict how quickly this can happen and thus limit the bandwidth in which the actuator can guarantee a zero–rate spring. When a time–varying force F(t) is commanded by generating motor motion defined by x(t) = F(t)/k, the load motion xl(t) can add constructive or destructive to the spring motion x(t) depending on their relative amplitude and phase.

When the load moves in a direction that naturally compresses the spring in the same direction as the desired force change, less motor motion is required and the effective bandwidth increases. When the load moves in the opposite direction, more motor motion is needed and bandwidth

2.1. Theoretical Background

decreases
The practical consequence for actuator design is that the spring stiffness should be chosen to match the task. For tasks requiring a constant force against a moving load, a softer spring causes small force errors and thus less motor effort. For tasks requiring varying forces on a stationary load, a stiffer spring is better because motor torque is transmitted more directly. No single spring stiffness is optimal for all tasks.

Control architectures

Pratt and Williamson proposed a control architecture that combines feedforward compensation with feedback correction. The architecture is shown in Figure 2.11, where the transfer functions are derived from Equation (2.29) by using s = jω → ω

2 = −s

2

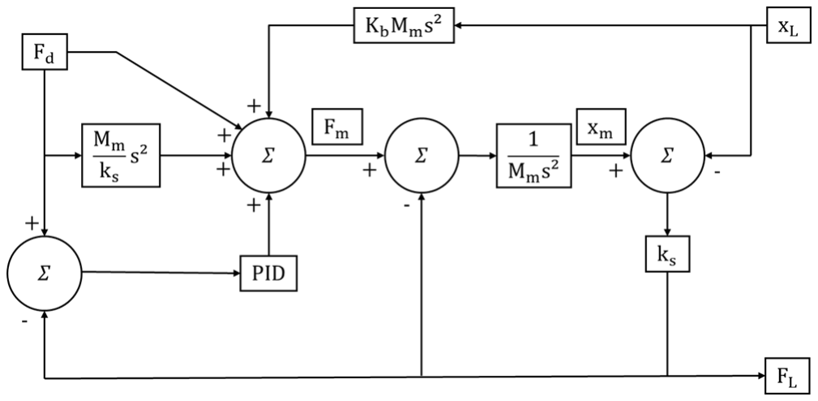
[picture p97: figure]

Figure 2.11: Torque control diagram with feedforward terms from [29].

The controller receives a desired output force Fd and the measured spring force Fl = ks(xm−xl).

The controller’s task is to make Fl track Fd.
The force error Fd − Fl
is processed by a PID feedback loop. Feedforward terms compensate for the components of the required motor force derived in Equation (2.29). The first two terms,

the desired output force and the motor acceleration needed to change the spring deflection, are fully compensated in the feedforward path. The third term, motor acceleration to track load motion, is only partially compensated by choosing a Kb < 1 to prevent instability. The combined feedforward and feedback output is a desired motor current, which translates to a motor torque [29].

Chapter 2. Literature Review

Yu et al. proposed a cascaded control architecture consisting of three nested loops [30]. The

architecture is shown in Figure 2.12.

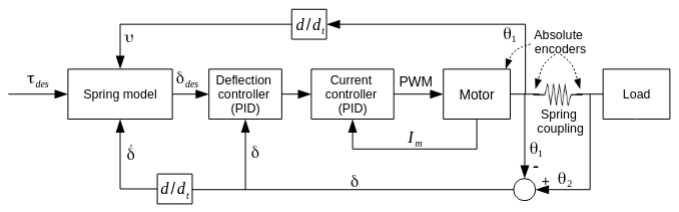
[picture p98: figure]

Figure 2.12: Torque control diagram from [30].

The outermost layer is the spring model, which converts the desired torque τdes into a desired spring deflection δdes. For a linear spring, this conversion is:

δdes =

τdes
Ks

(2.34)

When the spring exhibits nonlinear behaviour such as hysteresis, a data–driven model can be used instead. Yu et al. created their own model to better model the spring behaviour.
The middle loop is a PID controller that drives the measured spring deflection δ towards the desired deflection δdes. The spring deflection is computed as the difference between two absolute encoders placed on either side of the elastic element. The output of this deflection controller is a motor current command.
The innermost loop is a motor current controller (PID), which regulates the actual motor

current to match the commanded value.
Compared to the Pratt and Williamson architecture, the cascaded approach does not use explicit feedforward compensation for motor inertia or load motion. Instead, these effects are handled implicitly by the deflection PID. If friction or inertia causes the actual deflection to deviate from the desired value, the deflection controller increases the motor current until the error is corrected. The absence of feedforward terms makes the controller simpler to implement, at the cost of relying entirely on the feedback gains to reject disturbances. [29]–[32]

## 2.2 State of the Art

# Chapter 3

# Methodology

## 3.1 System Overview and Requirements

## 3.2 Mechanical Design

## 3.3 Hardware Architecture

### 3.3.1 CAN Bus Topology

### 3.3.2 Sensor Architecture

## 3.4 Sensor and Actuator Modeling

### 3.4.1 SET Spring Model

### 3.4.2 Motor and Transmission Model

## 3.5 Control Architecture

### 3.5.1 State Machine

### 3.5.2 Gravity Compensation and Floating Mode

### 3.5.3 Weighing Mode

### 3.5.4 Carrying Mode

### 3.5.5 Put-Down Mode

## 3.6 Software Implementation

### 3.6.1 Real-Time Architecture

Example code listing:

1 | while ( running ) {
2 | clock_nanosleep (...) ;
3 | // your code here
4 | }

Listing 3.1: Example listing.

Chapter 3. Methodology

### 3.6.2 Configuration

# Chapter 4

# Validation and Results

## 4.1 Experimental Setup

### 4.1.1 Hardware Configuration

### 4.1.2 Parameter Identification

## 4.2 Spring and Sensor Characterization

## 4.3 Controller Performance

## 4.4 Assisted Load Handling Evaluation

## 4.5 Discussion

Example table:

Table 4.1: Example results table.

Metric | Target | Achieved
Value 1 | X | Y
Value 2 | X | Y

Chapter 4. Validation and Results

# Chapter 5

# Conclusion and Future Work

## 5.1 Conclusion

## 5.2 Future Work

Chapter 5. Conclusion and Future Work

# References

[1] B. Oral, Y. Solak, and H. Durmuş, “Evaluation of absenteeism and presenteeism status

of factory employees,” WORK: A Journal of Prevention, Assessment & Rehabilitation, vol. 79, no. 1, pp. 449–457, Sep. 11, 2024, issn: 1051-9815, 1875-9270. doi: 10.3233/WOR-

230642. (https://doi.org/10.3233/WOR-230642) [Online]. Available: https://journals.sagepub.com/doi/10.3233/WOR-230642 (https://journals.sagepub.com/doi/10.3233/WOR-230642) (visited on 02/01/2026).

[2] A. Yassi, “Repetitive strain injuries,” THE LANCET,
[3] R. C. Vilella and A. K. R. Reddivari, “Musculoskeletal Examination,”
[4] IBV, “Musculoskeletal disorders caused by the most common job demands and ergonomic

risks,” 2017. [Online]. Available: https : / / ec . europa . eu / programmes / erasmus -

plus/project-result-content/c7cc4b4d-52c9-4b5e-a282-46f53f5f5e98/D2.1.

MSDs_job_demands_Revised.pdf. (https://ec.europa.eu/programmes/erasmus-plus/project-result-content/c7cc4b4d-52c9-4b5e-a282-46f53f5f5e98/D2.1.MSDs_job_demands_Revised.pdf)

[5] V. Gorasso, J. Van Der Heyden, R. De Pauw, I. Pelgrims, E. M. De Clercq, K. De

Ridder, S. Vandevijvere, S. Vansteelandt, B. Vaes, D. De Smedt, and B. Devleess-chauwer, “The health and economic burden of musculoskeletal disorders in Belgium from 2013 to 2018,” Population Health Metrics, vol. 21, no. 1, p. 4, Apr. 21, 2023,

issn: 1478-7954. doi: 10 . 1186 / s12963 - 023 - 00303 - z. (https://doi.org/10.1186/s12963-023-00303-z) [Online]. Available: https :

//pophealthmetrics.biomedcentral.com/articles/10.1186/s12963-023-00303-z (https://pophealthmetrics.biomedcentral.com/articles/10.1186/s12963-023-00303-z) (visited on 02/01/2026).

[6] M. Bender, M. Braun, P. Rally, and O. Scholtz, “Lightweight robots in manual assembly -best to start simply!” Fraunhofer institute for industrial engineering, 2016, p. 63. [Online].

Available: https://publica-rest.fraunhofer.de/server/api/core/bitstreams/

961b5036-c442-47db-84a6-b5334b4c1221/content. (https://publica-rest.fraunhofer.de/server/api/core/bitstreams/961b5036-c442-47db-84a6-b5334b4c1221/content)

[7] European Parliament. Directorate General for Parliamentary Research Services., Analysis

Exploring Risks and Opportunities Linked to the Use of Collaborative Industrial Robots in Europe. LU: Publications Office, 2023. doi: 10.2861/021129. (https://doi.org/10.2861/021129) [Online]. Available:

https://data.europa.eu/doi/10.2861/021129 (visited on 04/17/2026).

[8] M. J. Rosenstrauch, T. J. Pannen, and J. Krüger, “Human robot collaboration - using kinect v2 for ISO/TS 15066 speed and separation monitoring,” Procedia CIRP, vol. 76, pp. 183–186, 2018, issn: 22128271. doi: 10.1016/j.procir.2018.01.026. (https://doi.org/10.1016/j.procir.2018.01.026) [Online].

Available: https://linkinghub.elsevier.com/retrieve/pii/S2212827118300404 (visited on 02/02/2026).

References

[9] P. Chemweno, L. Pintelon, and W. Decre, “Orienting safety assurance with outcomes of

hazard analysis and risk assessment: A review of the ISO 15066 standard for collaborative robot systems,” Safety Science, vol. 129, p. 104 832, Sep. 2020, issn: 09257535. doi:

10.1016/j.ssci.2020.104832. (https://doi.org/10.1016/j.ssci.2020.104832) [Online]. Available: https://linkinghub.elsevier.

com/retrieve/pii/S0925753520302290 (https://linkinghub.elsevier.com/retrieve/pii/S0925753520302290) (visited on 04/15/2026).

[10] B. Siciliano and O. Khatib, Eds., Springer Handbook of Robotics (Springer Handbooks).

Cham: Springer International Publishing, 2016, isbn: 978-3-319-32550-7 978-3-319-32552-

1. doi: 10.1007/978-3-319-32552-1. (https://doi.org/10.1007/978-3-319-32552-1) [Online]. Available: https://link.springer.

com/10.1007/978-3-319-32552-1 (https://link.springer.com/10.1007/978-3-319-32552-1) (visited on 04/14/2026).

[11] R. Gregor, A. Babinec, F. Duchoň, and M. Dobiš, “Hand Guiding a Virtual Robot Using

a Force Sensor,” Acta Mechanica et Automatica, vol. 15, no. 3, pp. 177–186, Sep. 1, 2021, issn: 2300-5319. doi: 10 . 2478 / ama - 2021 - 0023. (https://doi.org/10.2478/ama-2021-0023) [Online]. Available: https :

//www.sciendo.com/article/10.2478/ama-2021-0023 (visited on 02/03/2026).

[12] A. Hameed, A. Ordys, J. Możaryn, and A. Sibilska-Mroziewicz, “Control System Design

and Methods for Collaborative Robots: Review,” Applied Sciences, vol. 13, no. 1,
p. 675, Jan. 3, 2023, issn: 2076-3417. doi: 10.3390/app13010675. (https://doi.org/10.3390/app13010675) [Online]. Available:

https://www.mdpi.com/2076-3417/13/1/675 (visited on 02/03/2026).

[13] E. Montini, F. Daniele, L. Agbomemewa, M. Confalonieri, V. Cutrona, A. Bettoni,
P. Rocco, and A. Ferrario, “Collaborative Robotics: A Survey From Literature and Practitioners Perspectives,” Journal of Intelligent & Robotic Systems, vol. 110, no. 3,
p. 117, Aug. 6, 2024, issn: 1573-0409. doi: 10.1007/s10846-024-02141-z. (https://doi.org/10.1007/s10846-024-02141-z) [Online].

Available: https://link.springer.com/10.1007/s10846-024-02141-z (visited on 02/03/2026).

[14] “UR30 Collaborative Robot | 35 kg Payload Cobot | Universal Robots.” (), [Online]. Avail-

able: https://www.universal-robots.com/products/ur30/ (visited on 04/19/2026).

[15] “Collaborative Robots (Cobots) | FANUC America,” fanucamerica. (), [Online]. Available:

https://www.fanucamerica.com/products/robots/series/collaborative-robot (visited on 04/19/2026).

[16] S. M. Group. “Hand Guiding Robots.” (Dec. 1, 2021), [Online]. Available: https://

www.techbriefs.com/component/content/article/40390-hand-guiding-robots (visited on 04/19/2026).

[17] “Configuring FANUC Robot Payload & Collision Guard Settings,” Industrial Monitor Direct. (Apr. 11, 2026), [Online]. Available: https://industrialmonitordirect.com/

blogs/knowledgebase/fanuc- robot- payload- collision- guard- configuration-guide (https://industrialmonitordirect.com/blogs/knowledgebase/fanuc-robot-payload-collision-guard-configuration-guide) (visited on 04/19/2026).

[18] V. Arakelian, “GRAVITY COMPENSATION IN ROBOTICS – A REVIEW,” 2019.
[19] “Industrial Lift Assist Devices for Manufacturing | 3ARM®,” 3ARM - Tool Balancers
& Manipulators Arms. (), [Online]. Available: https://toolbalancerarms-3arm.com/(visited on 04/20/2026).

References

[20] “Catalogues, user manuals, certificates and further downloads from SUSPA.” (), [Online].

Available: https://www.suspa.com/in/downloads (visited on 04/20/2026).

[21] “Spring balancer & balancer - ideal for the ergonomic workplace,” transprotec. (), [Online]. Available: https://www.transprotec.de/ (visited on 04/20/2026).
[22] Cobot, in Wikipedia, Apr. 11, 2026. [Online]. Available: https://en.wikipedia.org/w/

index.php?title=Cobot&oldid=1348168033#cite_note-22 (https://en.wikipedia.org/w/index.php?title=Cobot&oldid=1348168033#cite_note-22) (visited on 04/21/2026).

[23] “Industrial Manipulators and load handling solutions,” Indeva Group. (), [Online].

Available: https://www.indevagroup.com/industrial-manipulators/ (visited on 04/20/2026).

[24] J. Colgate, M. Peshkin, and S. Klostermeyer, “Intelligent assist devices in industrial applications: A review,” in Proceedings 2003 IEEE/RSJ International Conference on Intelligent Robots and Systems (IROS 2003) (Cat. No.03CH37453), vol. 3, Las Vegas,

Nevada, USA: IEEE, 2003, pp. 2516–2521, isbn: 978-0-7803-7860-5. doi: 10.1109/

IROS.2003.1249248. (https://doi.org/10.1109/IROS.2003.1249248) [Online]. Available: http://ieeexplore.ieee.org/document/1249248/ (http://ieeexplore.ieee.org/document/1249248/) (visited on 04/20/2026).

[25] H. F. N. Al-Shuka, S. Leonhardt, W.-H. Zhu, R. Song, C. Ding, and Y. Li, “Active

Impedance Control of Bioinspired Motion Robotic Manipulators: An Overview,” Applied Bionics and Biomechanics, vol. 2018, pp. 1–19, Oct. 18, 2018, issn: 1176-2322, 1754-

2103. doi: 10.1155/2018/8203054. (https://doi.org/10.1155/2018/8203054) [Online]. Available: https://www.hindawi.com/

journals/abb/2018/8203054/ (https://www.hindawi.com/journals/abb/2018/8203054/) (visited on 04/10/2026).

[26] P. Song, Y. Yu, and X. Zhang, “Impedance Control of Robots: An Overview,” in 2017 2nd International Conference on Cybernetics, Robotics and Control (CRC), Chengdu:

IEEE, Jul. 2017, pp. 51–55, isbn: 978-1-5386-0677-3. doi: 10.1109/CRC.2017.20. (https://doi.org/10.1109/CRC.2017.20)

[Online]. Available: http://ieeexplore.ieee.org/document/8328305/ (visited on 04/10/2026).

[27] R. Anderson and M. Spong, “Hybrid impedance control of robotic manipulators,”

IEEE Journal on Robotics and Automation, vol. 4, no. 5, pp. 549–556, Oct. 1988, issn:

08824967. doi: 10.1109/56.20440. (https://doi.org/10.1109/56.20440) [Online]. Available: http://ieeexplore.ieee.org/document/20440/ (http://ieeexplore.ieee.org/document/20440/) (visited on 04/10/2026).

[28] P. Song, Y. Yu, and X. Zhang, “A Tutorial Survey and Comparison of Impedance

Control on Robotic Manipulation,” Robotica, vol. 37, no. 5, pp. 801–836, May 2019, issn: 0263-5747, 1469-8668. doi: 10.1017/S0263574718001339. (https://doi.org/10.1017/S0263574718001339) [Online]. Available:

https : / / www . cambridge . org / core / product / identifier / S0263574718001339 /

type/journal_article (https://www.cambridge.org/core/product/identifier/S0263574718001339/type/journal_article) (visited on 04/10/2026).

[29] G. Pratt and M. Williamson, “Series elastic actuators,” in Proceedings 1995 IEEE/RSJ

International Conference on Intelligent Robots and Systems. Human Robot Interaction and Cooperative Robots, vol. 1, Pittsburgh, PA, USA: IEEE Comput. Soc. Press, 1995, pp. 399–406, isbn: 978-0-8186-7108-1. doi: 10 . 1109 / IROS . 1995 . 525827. (https://doi.org/10.1109/IROS.1995.525827) [Online].

Available: http://ieeexplore.ieee.org/document/525827/ (visited on 04/12/2026).

References

[30] B. Yu, J. De Gea Fernández, Y. Kassahun, and V. Bargsten, “Learning the Elasticity of

a Series-Elastic Actuator for Accurate Torque Control,” in Advances in Artificial Intelligence: From Theory to Practice, S. Benferhat, K. Tabia, and M. Ali, Eds., vol. 10350, Cham: Springer International Publishing, 2017, pp. 543–552, isbn: 978-3-319-60041-3 978-3-319-60042-0. doi: 10.1007/978-3-319-60042-0_60. (https://doi.org/10.1007/978-3-319-60042-0_60) [Online]. Available: http:

//link.springer.com/10.1007/978-3-319-60042-0_60 (visited on 04/12/2026).

[31] J. Pratt, B. Krupp, and C. Morse, “Series elastic actuators for high fidelity force

control,” Industrial Robot: An International Journal, vol. 29, no. 3, pp. 234–241, Jun. 1, 2002, issn: 0143-991X. doi: 10.1108/01439910210425522. (https://doi.org/10.1108/01439910210425522) [Online]. Available: http:

//www.emerald.com/ir/article/29/3/234-241/432405 (visited on 04/12/2026).

[32] B. Hu, H. Ren, Z. Zhou, F. Liu, and H. Yu, “Research on variable impedance control of

SEA-driven upper limb rehabilitation robot based on singular perturbation method,” International Journal of Advanced Robotic Systems, vol. 22, no. 4, p. 17 298 806 251 325 135, Jul. 2025, issn: 1729-8806, 1729-8814. doi: 10.1177/17298806251325135. (https://doi.org/10.1177/17298806251325135) [Online].

Available: https://journals.sagepub.com/doi/10.1177/17298806251325135 (visited on 04/12/2026).

# 2D Manufacturing Drawings

.1 | CNC Part 1
.2 | CNC Part 2
.3 | CNC Part 3

Appendix . 2D Manufacturing Drawings

# Additional Experimental Results

Appendix . Additional Experimental Results

# Source Code

https://github.com/username/repository
