OsubuDc/Thesis/V1/ThesisProposal.pdf

# Thesis Description

# Student: Oskar De Clerck

Date: October 2025

Industrial assembly tasks remain among the most ergonomically demanding operations in manu-

facturing, often requiring workers to perform repetitive and force-intensive motions. These activities

significantly contribute to the global prevalence of musculoskeletal disorders (MSDs) which represents a

global health challenge affecting an estimated 1.71 billion people worldwide, being the leading contributor

to disability [1].

In Belgium, approximately 2.5 million people were affected by MSD in 2018, resulting in direct

medical costs of 3 billion euros and indirect costs of 2 billion euros annually [2].

Work-related musculoskeletal disorders (WMSDs) are caused by repetitive movements, awkward

postures and excessive use of force over a long period of time [3]. In European industries 50 percent of

work absenteeism of employees is affected by WMSDs. These employees are also absent for a longer

period of time compared to workers with other health problems. WMSDs are responsible for permanent

incapacity in 60 percent of all reported cases. The financial costs in Europe are estimated to be 240

billion euros, which is 2 percent of the gross domestic product of the EU-15 [4] [5].

By using a robotic arm to compensate the weight of heavy parts and/or reduce repetitive motions in

assembly tasks, this use case aims to reduce the physical strain on the human body. Reducing physical

and mental fatigue will result in less WMSDs and reduce its economic impact while simultaneously

improving throughput and quality of production.

# Use Case Description

To ground the proposed research in a realistic industrial context, this thesis focuses on a representative col-

laborative assembly scenario involving human-robot interaction during the manipulation and placement

of mechanical components. The selected use case is motivated by repetitive assembly operations, such

as gearbox or substructure assemblies, where parts of varying size and mass (often between 1 kilogram

and 5 kilogram) must be repeatedly retrieved, positioned and fitted by an operator. These tasks combine

precision requirements with physical loads, making them ideal for collaborative assistance.

The assembly space is divided into two functionally distinct zones which remain dynamically con-

nected. These zones are separated by a laser safety screen which ensures human safety.

- Robot workspace (autonomous zone): The robot performs autonomous actions such as part retrieval

and pre-positioning. In this zone, safety is guaranteed by means of human-robot separation, while

impedance control ensures accurate motion and force tracking.

- Human workspace (collaborative zone): The operator performs fine alignment or assembly tasks.

The safety screen acts as a logical boundary rather than a rigid divider. Its primary function is to

trigger the controller’s transfer between autonomous (impedance) mode to collaborative (hybrid

admittance-impedance) mode. Laser safety screens are represented in industrial safety norms

concerning physical human-robot interaction (pHRI) and industrial robots, such as, but not limited

to, ISO/TS 15066 and ISO 10218-2.

# Workflow

Industrial environments already use software to guide human operators during the assembly process.

This software can be repurposed to guide the robotic arm to pick the right parts in the correct sequence.

After the correct part has been grabbed, the robotic arm brings this part to the border of its workspace.

If the human operator moves within the robot workspace during autonomous movement, the robotic arm

will stop moving to ensure human safety. When the robotic arm is at a standstill at a predefined switching

point, the human operator grabs the robotic arm and guides the end effector to the correct position in the

human workspace. The robotic arm will only compensate the weight of the parts, and will remain passive

as long as it is within the human workspace. Once the assembly is complete, the human operator guides

the robotic arm back within the robot workspace, where it regains autonomous impedance control and

fetches the next component.

This workflow achieves a dynamic interaction between human and robot, eliminating downtime

associated with rigid separation of work zones [6][7].

# Control concept

The proposed robotic system operates within two functional zones:

- Autonomous workspace (robot-only region), where the robot retrieves, positions or manipulates

parts independently

- Collaborative workspace (shared region), where direct physical guidance from the human operator

occurs during assembly.

Transitions between these zones demand different dynamic behaviors: precision and stiffness in the

autonomous region, whereas compliance, back-drivability and safety in the collaborative region. The

control framework therefore integrates impedance control for autonomous tasks and hybrid admittance-

impedance control for human-guided interaction, with a supervisory safety layer ensuring smooth transi-

tions between the two modes.

A series elastic transmission (SET) forms the mechanical foundation of this architecture. By intro-

ducing a controlled torsional compliance between motor and load, the SET serves as a passive safety

filter—absorbing impacts and allowing accurate measurement of interaction forces through spring deflec-

tion. Yet elasticity alone is insufficient: it introduces unmodeled dynamics such as backlash, frictional

hysteresis and time-dependent compliance variations that can degrade precision.

To compensate for these nonlinearities while preserving compliance, a disturbance observer (DOB)

is incorporated into the torque-control loop. | The DOB estimates the effect of all disturbances such as
mechanical backlash, spring nonlinearity, friction, torque ripple, and cancels them in real time. | This

restores force-tracking fidelity without compromising the intrinsic safety benefits of elasticity [8][9].

# Research Objectives

The primary objectives of this thesis are as follows:

1. To design and implement a disturbance observer capable of real-time compensation of combined

disturbances within the hybrid (admittance/impedance) control framework.

2. To analyse and provide stability and passivity proofs of the proposed controller architecture using

classical methods (e.g., Nyquist stability criterion) and Lyapunov theory.

3. To design and build a 3-DoF experimental test bench incorporating the series elastic transmission,

the laser safety interface for zone separation, and the collaborative arm hardware.

4. To experimentally validate the proposed use-case for weight compensation and human–robot coop-

erative assembly of heavy parts: quantify improvements in productivity (e.g., target 30% reduction

in cycle times) and ergonomics (e.g., measurable reduction in MSD risk factors among operators).

# Expected Outcomes and Impact

The expected outcomes of this thesis include:

- A validated experimental prototype demonstrating pHRI in an industrial-style assembly cell with

cobot assistance.

- Open-source code and documentation for the hybrid control algorithm and disturbance observer

implementation.

# References

[1] World Health Organization. Musculoskeletal health – fact sheet. Accessed: 2025-10-27. 2022. url:

# https://www.who.int/news-room/fact-sheets/detail/musculoskeletal-condition

# s. (https://www.who.int/news-room/fact-sheets/detail/musculoskeletal-conditions)

[2] V. Gorasso, J. Van der Heyden, R. De Pauw, et al. “The health and economic burden of muscu-

loskeletal disorders in Belgium from 2013 to 2018”. In: Population Health Metrics 21.4 (2023). doi:

10.1186/s12963-023-00303-z. url: https://doi.org/10.1186/s12963-023-00303-z.

[3] European Agency for Safety and Health at Work. Musculoskeletal disorders. Accessed: 2025-10-27.

2025. url: https://osha.europa.eu/en/themes/musculoskeletal-disorders.

# [4] European Environment Agency. EU-15. https://www.eea.europa.eu/help/glossary/eea-

glossary/eu-15. (https://www.eea.europa.eu/help/glossary/eea-glossary/eu-15) Accessed: 2025-10-24. n.d.

[5] R. Govaerts, B. Tassignon, J. Ghillebert, et al. “Prevalence and incidence of work-related mus-

culoskeletal disorders in secondary industries of 21st century Europe: a systematic review and
meta-analysis”. In: BMC Musculoskeletal Disorders 22 (2021), p. 751. doi: 10.1186/s12891-02

1-04615-9. url: https://doi.org/10.1186/s12891-021-04615-9.

[6] Praxie Consulting. Cobot applications in manufacturing. Accessed: 2025-10-27. 2024. url: http

s://praxie.com/cobot-applications-in-manufacturing/.

[7] John Smith, Anna Müller, and Luca Rossi. “Impact of collaborative robots on assembly accuracy
and workload”. In: Computers & Industrial Engineering 185 (2024), p. 109231. doi: 10.1016/j

.cie.2024.109231. (https://doi.org/10.1016/j.cie.2024.109231) url: https://www.sciencedirect.com/science/article/pii/S000

# 3687024000838. (https://www.sciencedirect.com/science/article/pii/S0003687024000838)

[8] Neil Paine, Luis Sentis, and Christopher Combes. Design and Control of a Prismatic Series Elastic Actuator for Human-Robot Interaction. Tech. rep. University of Texas at Austin, Human Centered

# Robotics Lab, 2016. url: https://sites.utexas.edu/hcrl/files/2016/01/prismatic-s

# ea-paine.pdf. (https://sites.utexas.edu/hcrl/files/2016/01/prismatic-sea-paine.pdf)

[9] Hyungbo Shim. Disturbance Observer. Accessed: 2025-10-27. Jan. 2021. url: https://arxiv

# .org/abs/2101.02859. (https://arxiv.org/abs/2101.02859)
