OsubuDc/Thesis/ThesisV2/Graphics/MaxonMotor.pdf

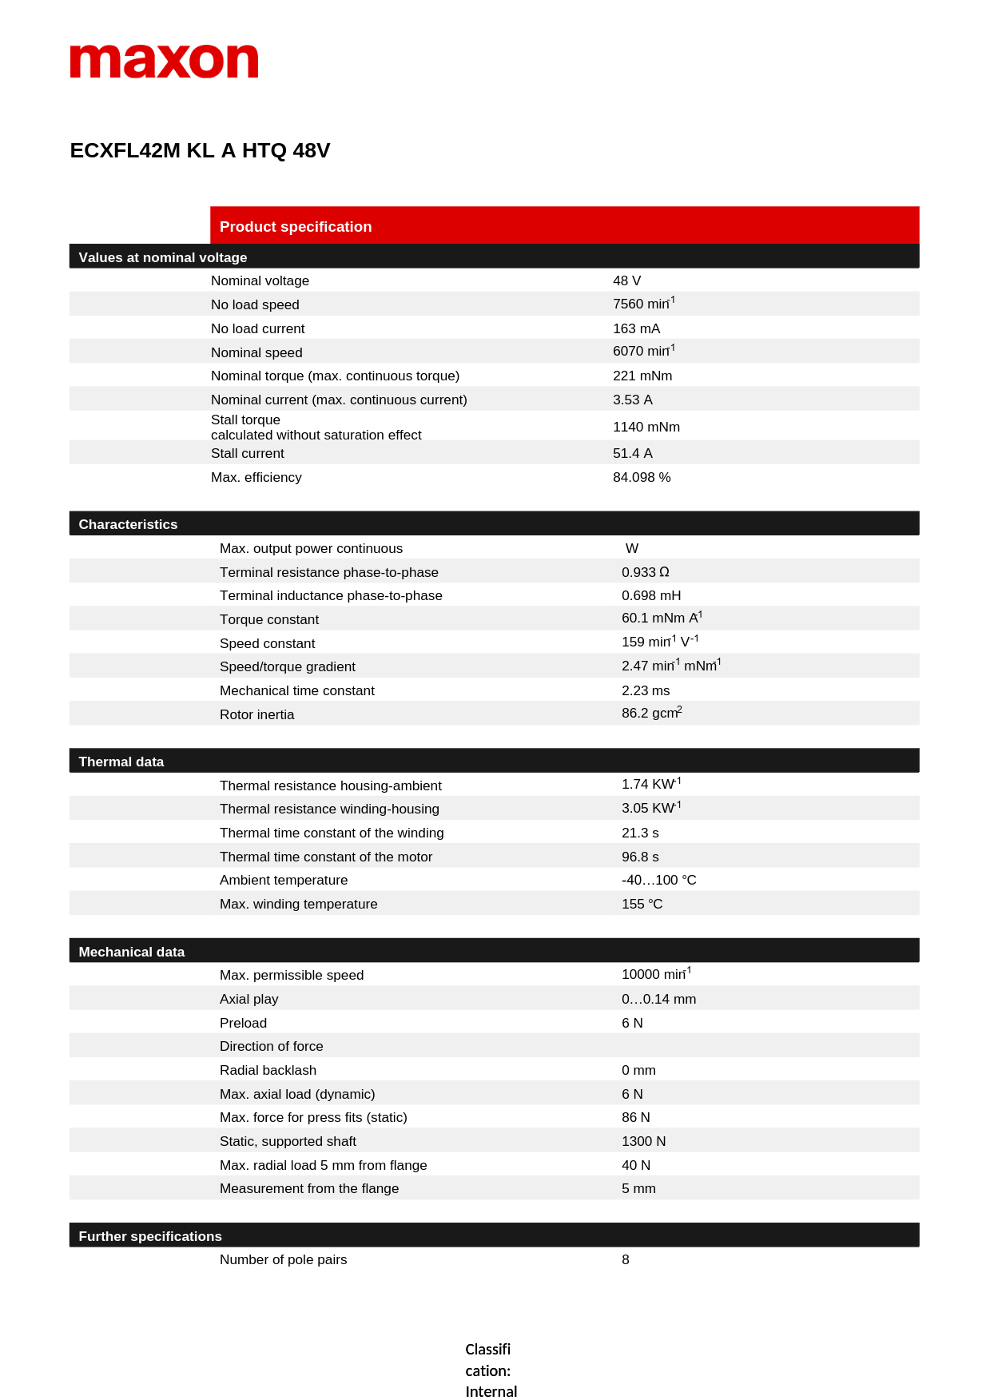
[picture p99: page 1]
