OsubuDc/Thesis/ThesisV2/Graphics/pearsonKfactor.pdf

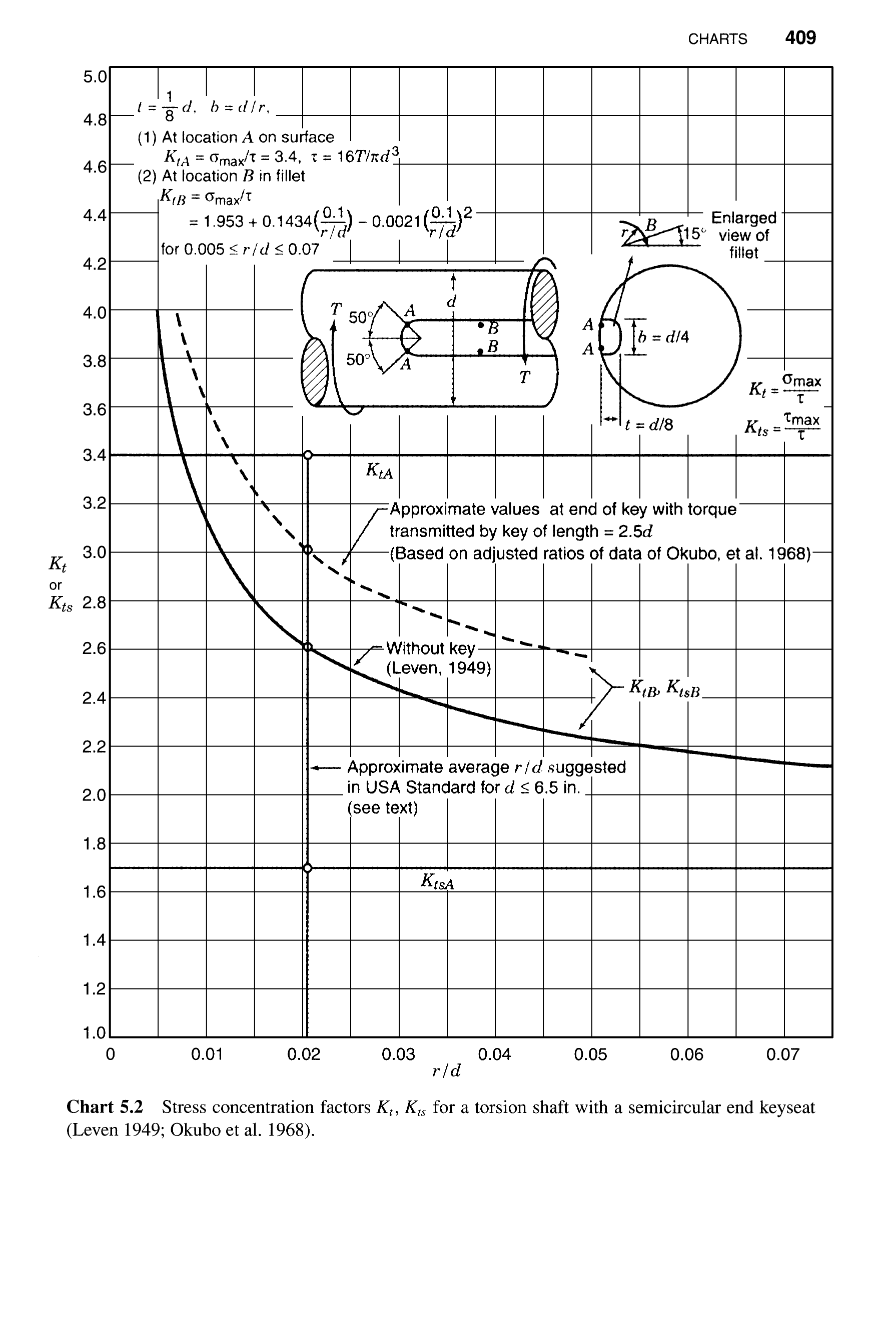
[picture p100: page 1]
