OsubuDc/Thesis/VSCODE_LaTex/main.pdf

Hier citeer ik de paper van Shim shimDisturbanceObserver2020.

1
