OsubuDc/Thesis/ThesisV2/Graphics/AngledBottomView_sl.png

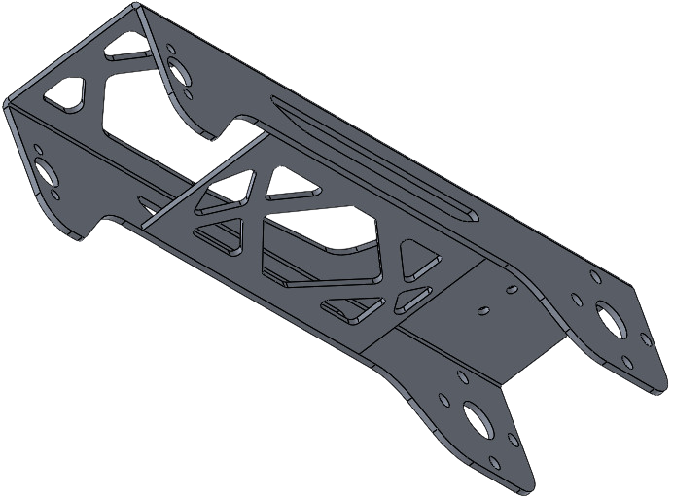
ThesisV2/Graphics/AngledBottomView_sl.png
