OsubuDc/Thesis/ThesisV2/Graphics/BlurredSetOverview.png

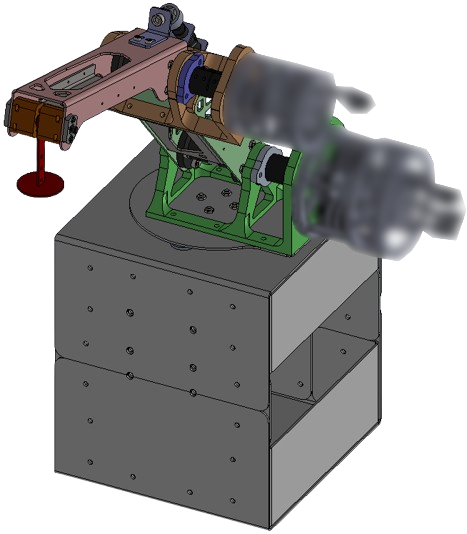
ThesisV2/Graphics/BlurredSetOverview.png
