OsubuDc/Thesis/ThesisV2/Graphics/forearm_other_sideview.png

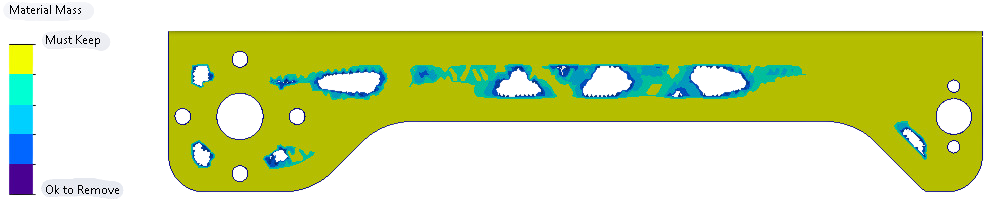
ThesisV2/Graphics/forearm_other_sideview.png
