OsubuDc/Thesis/ThesisV2/Graphics/forearmvonmisestop.png

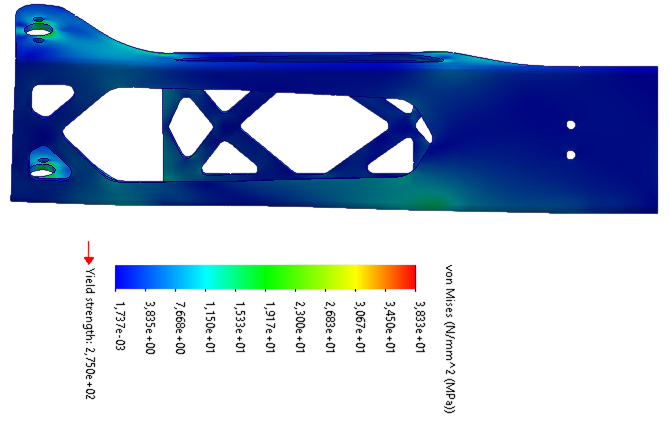
ThesisV2/Graphics/forearmvonmisestop.png
