OsubuDc/Thesis/ThesisV2/Graphics/handguiding_precise_positioning.png

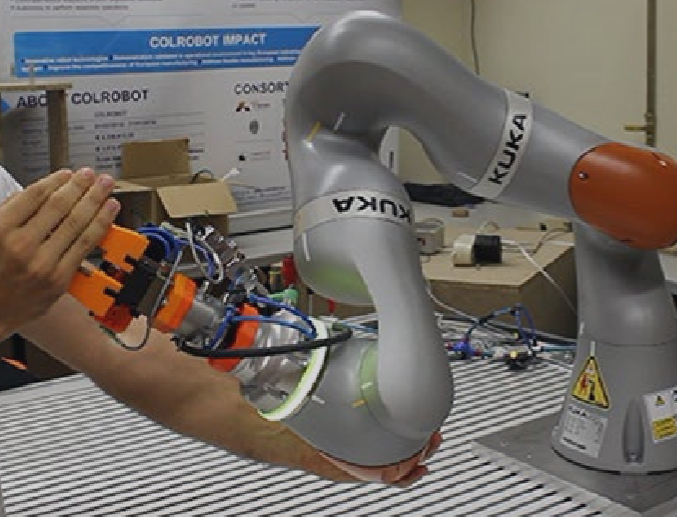
ThesisV2/Graphics/handguiding_precise_positioning.png
