OsubuDc/Thesis/ThesisV2/Graphics/key.png

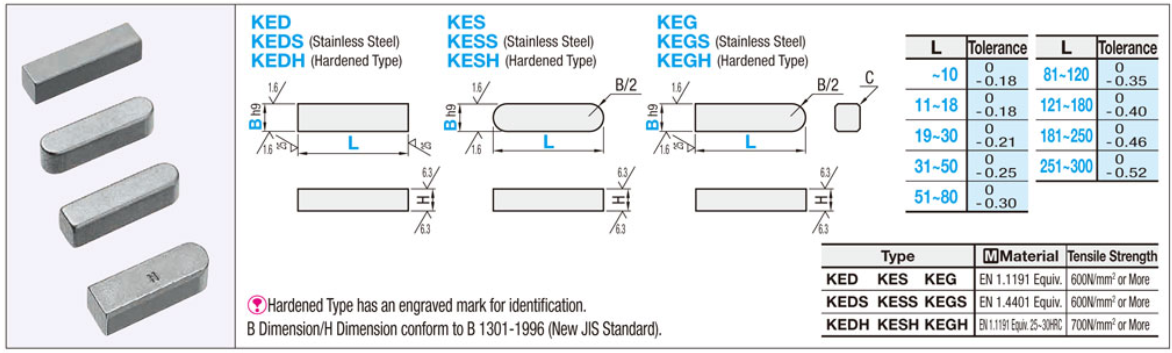
ThesisV2/Graphics/key.png
