OsubuDc/Thesis/ThesisV2/Graphics/Schermafbeelding 2026-01-20 165325-Photoroom.png

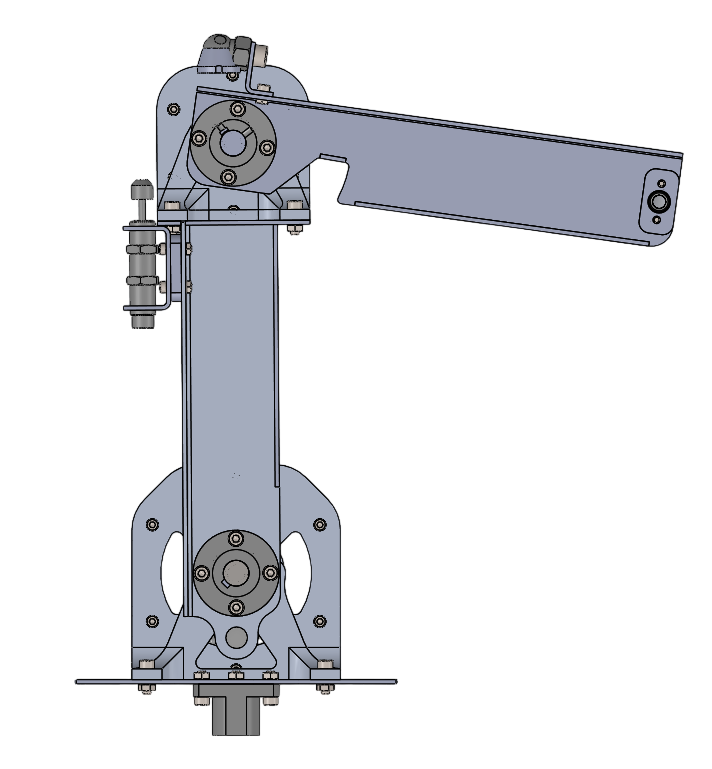
ThesisV2/Graphics/Schermafbeelding 2026-01-20 165325-Photoroom.png
