OsubuDc/Thesis/ThesisV2/Graphics/Schermafbeelding 2026-05-12 100902.png

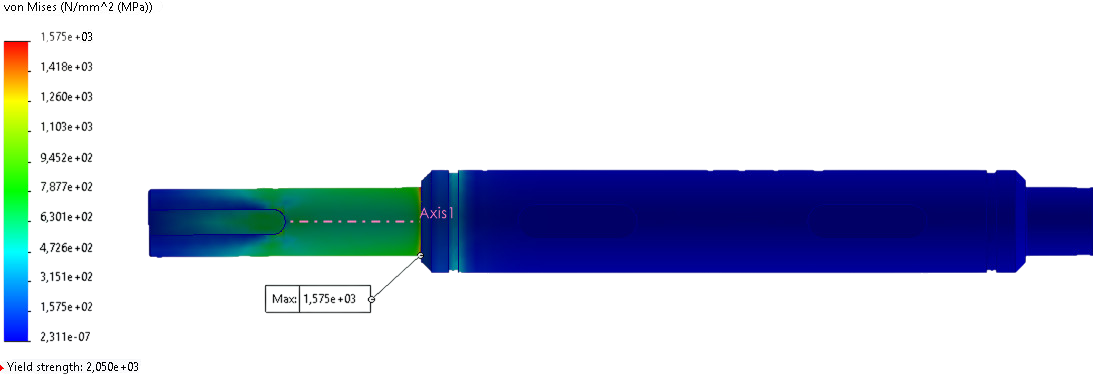
ThesisV2/Graphics/Schermafbeelding 2026-05-12 100902.png
