OsubuDc/Thesis/ThesisV2/Graphics/SEA_Schematic.png

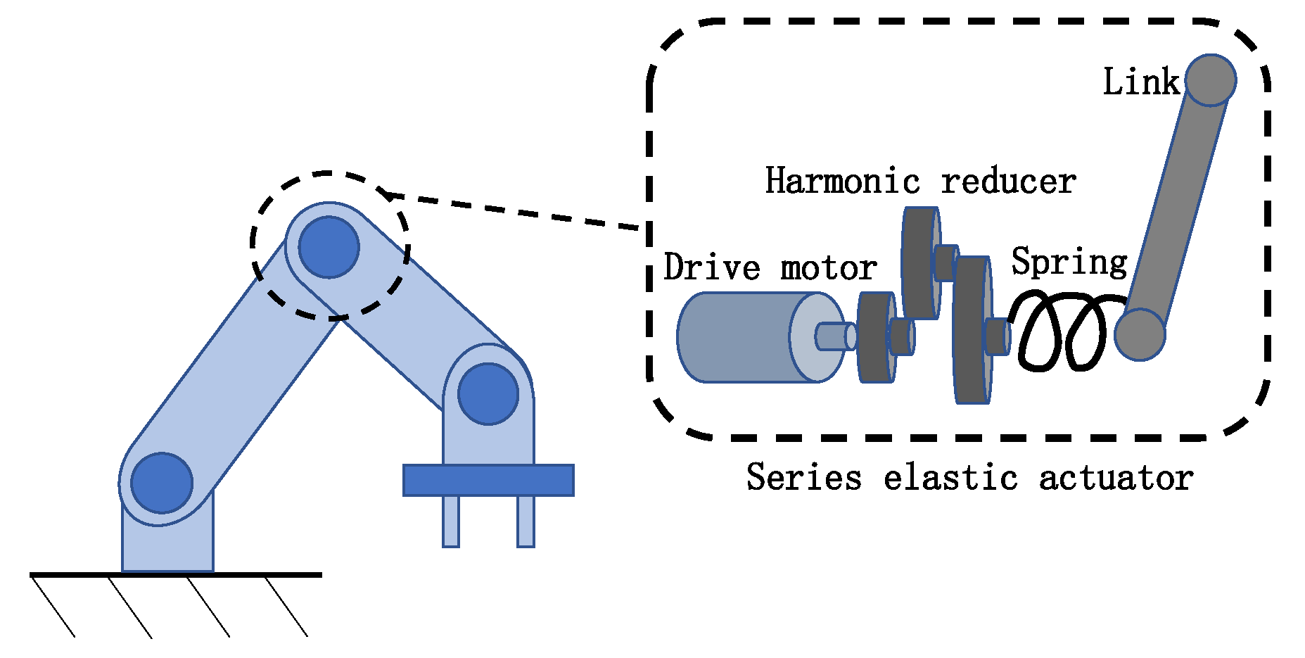
ThesisV2/Graphics/SEA_Schematic.png
