OsubuDc/Thesis/ThesisV2/Graphics/seaspringmass_withbackground.png

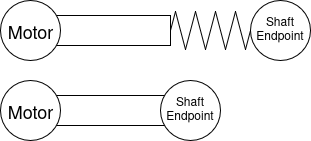
ThesisV2/Graphics/seaspringmass_withbackground.png
