OsubuDc/Thesis/ThesisV2/Graphics/shaft_20nm_max-Photoroom.png

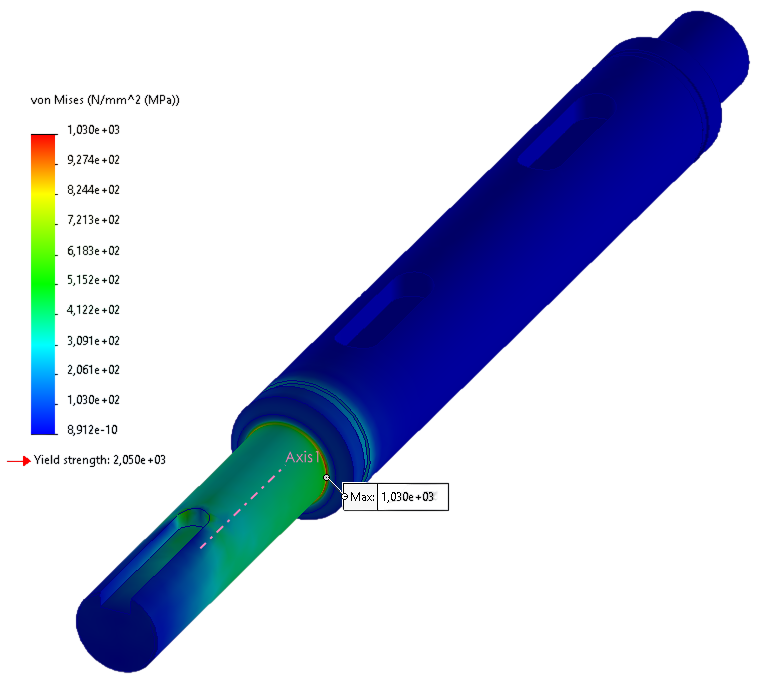
ThesisV2/Graphics/shaft_20nm_max-Photoroom.png
