OsubuDc/Thesis/ThesisV2/Graphics/Shaft_20nm_vm-Photoroom.png

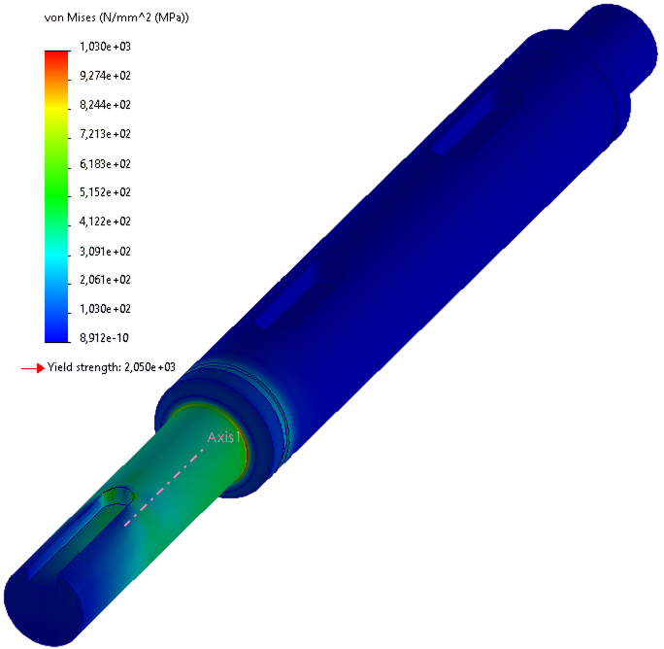
ThesisV2/Graphics/Shaft_20nm_vm-Photoroom.png
