OsubuDc/Thesis/ThesisV2/Graphics/shaft_torque.png

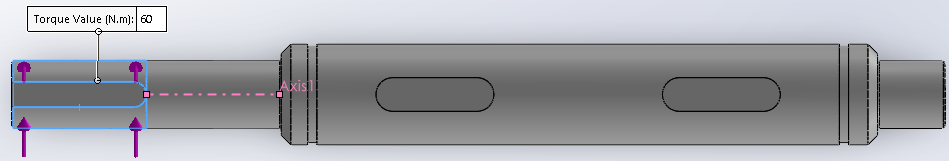
ThesisV2/Graphics/shaft_torque.png
