OsubuDc/Thesis/ThesisV2/Graphics/shaftfixed.png

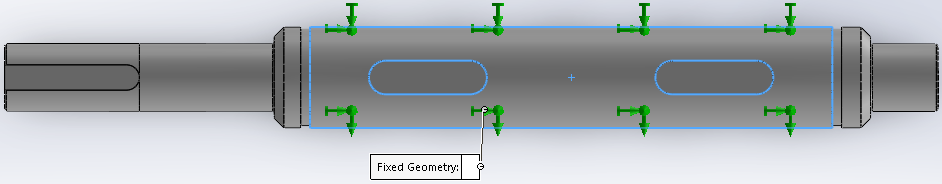
ThesisV2/Graphics/shaftfixed.png
