OsubuDc/Thesis/ThesisV2/Graphics/shaftfocused-Photoroom.png

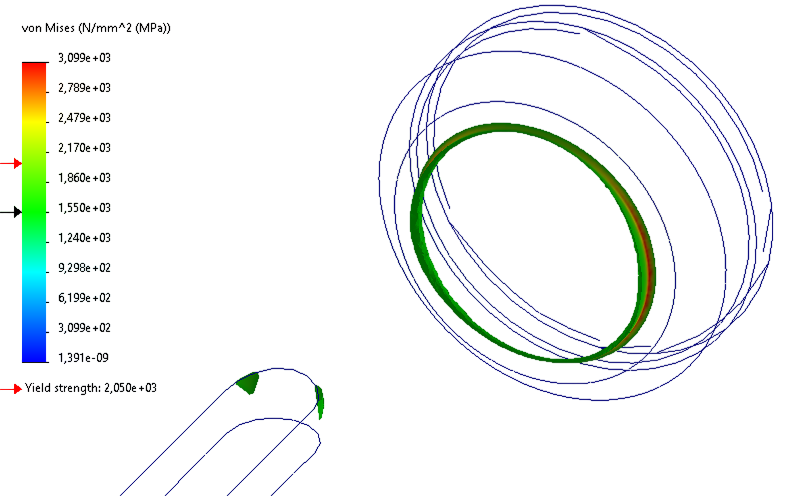
ThesisV2/Graphics/shaftfocused-Photoroom.png
