OsubuDc/Thesis/ThesisV2/Graphics/shaftvonmises-Photoroom.png

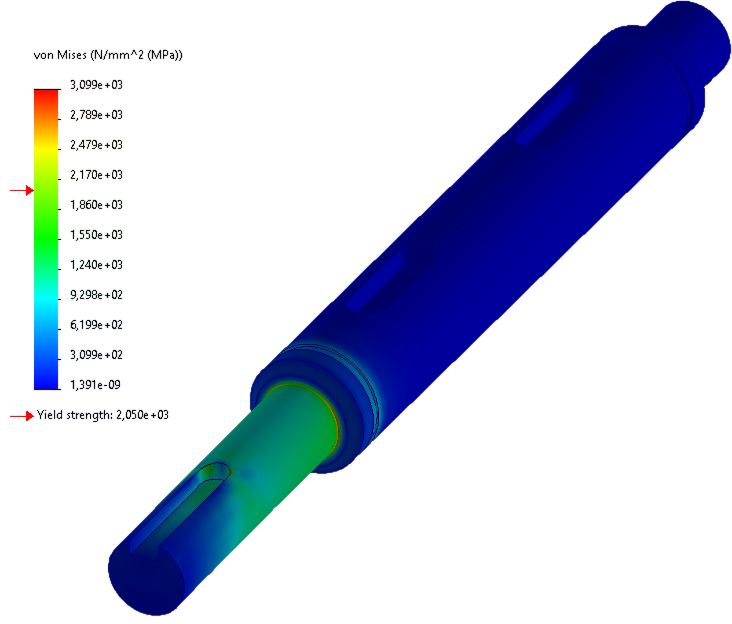
ThesisV2/Graphics/shaftvonmises-Photoroom.png
