OsubuDc/Thesis/ThesisV2/Graphics/SL_side.png

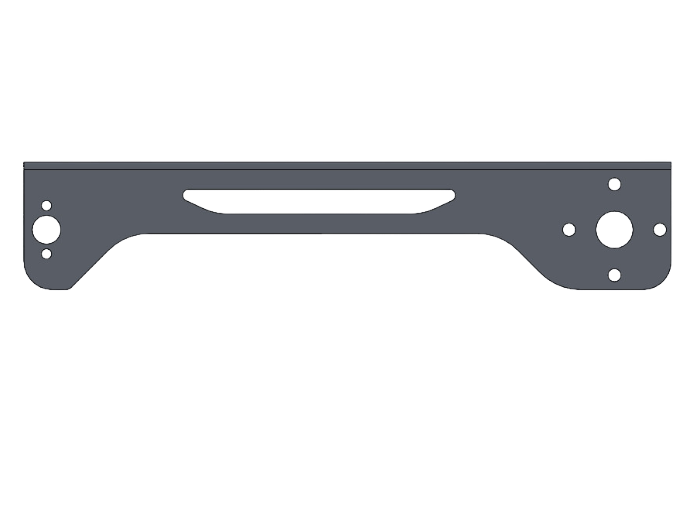
ThesisV2/Graphics/SL_side.png
