OsubuDc/Thesis/ThesisV2/Graphics/standalonearm.jpg

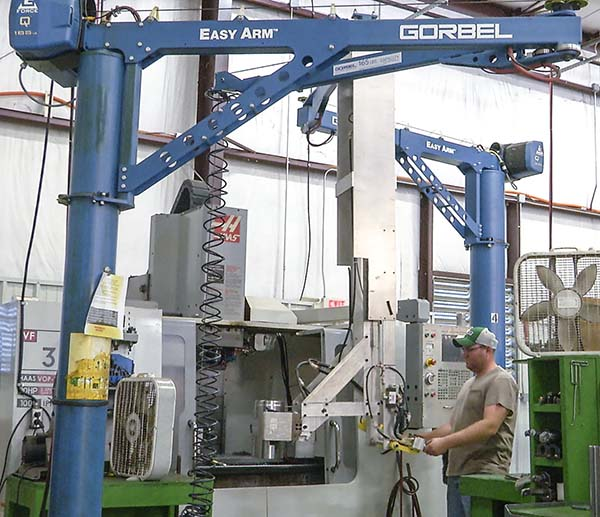
ThesisV2/Graphics/standalonearm.jpg
