OsubuDc/Thesis/ThesisV2/Graphics/torquesurfaceshoulder.png

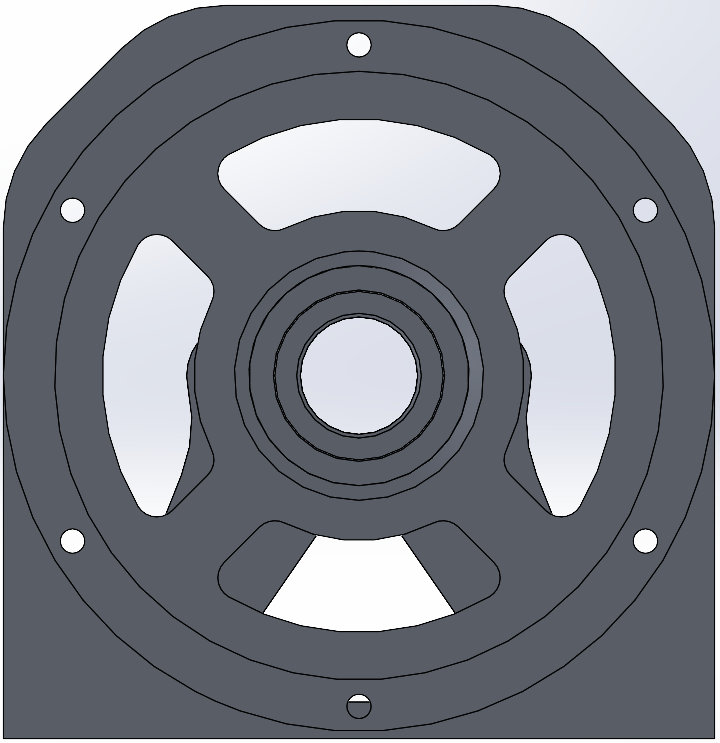
ThesisV2/Graphics/torquesurfaceshoulder.png
