OsubuDc/Thesis/ThesisV2/Graphics/TransparentViewBase.png

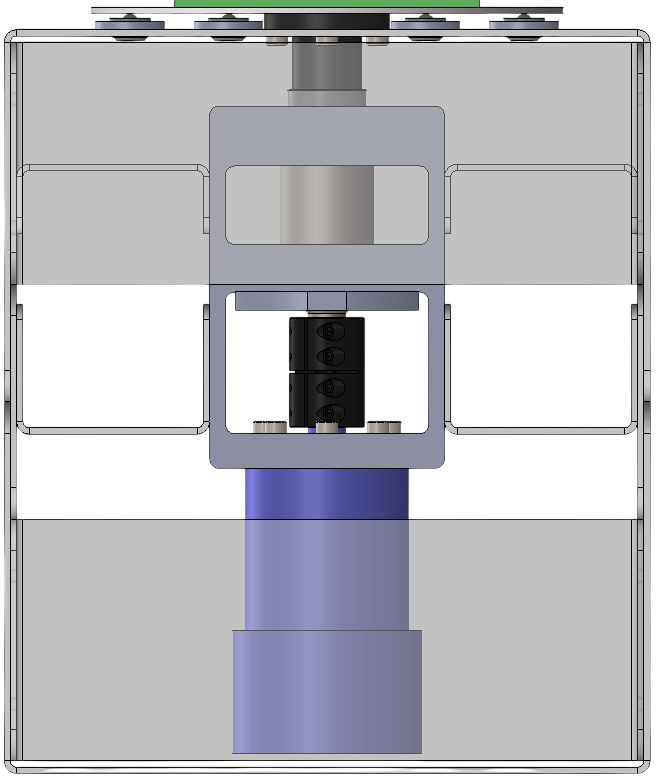
ThesisV2/Graphics/TransparentViewBase.png
