OsubuDc/Thesis/ThesisV2/Graphics/VMaboveSL.png

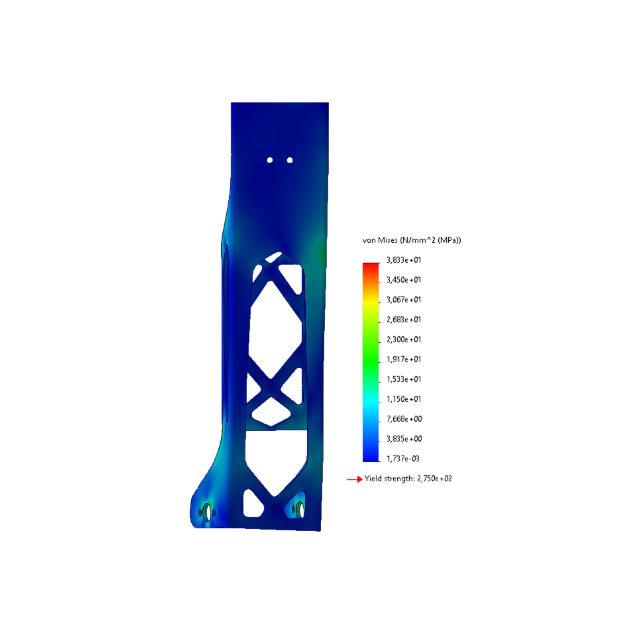
ThesisV2/Graphics/VMaboveSL.png
