OsubuDc/Thesis/ThesisV2/Graphics/VMFrontSL.png

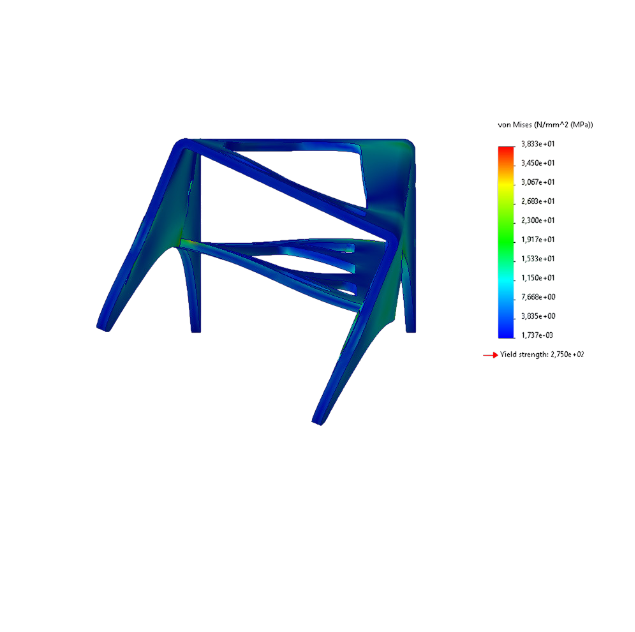
ThesisV2/Graphics/VMFrontSL.png
