OsubuDc/Thesis/ThesisV2/Graphics/VMMaxSL.png

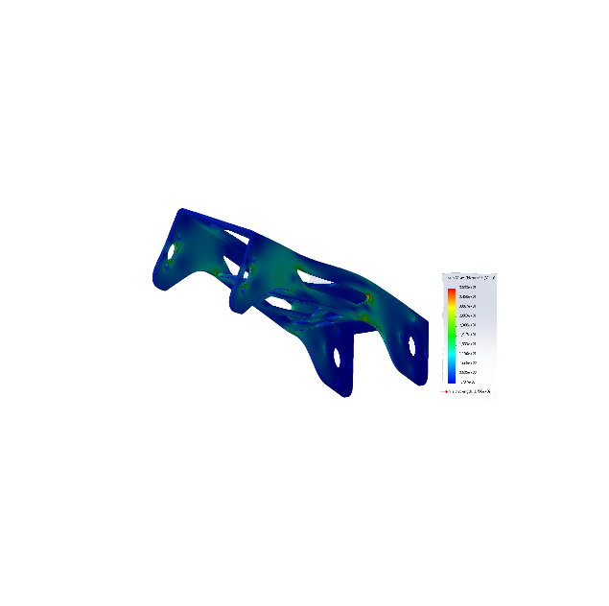
ThesisV2/Graphics/VMMaxSL.png
