OsubuDc/Thesis/ThesisV2/Graphics/VMsidenSL.png

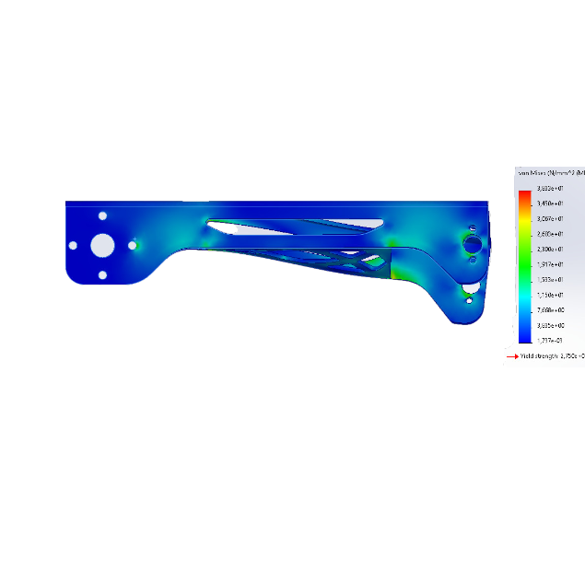
ThesisV2/Graphics/VMsidenSL.png
