OsubuDc/Thesis/Matlab/V2.1/V2_URDF/meshes/base_link.STL

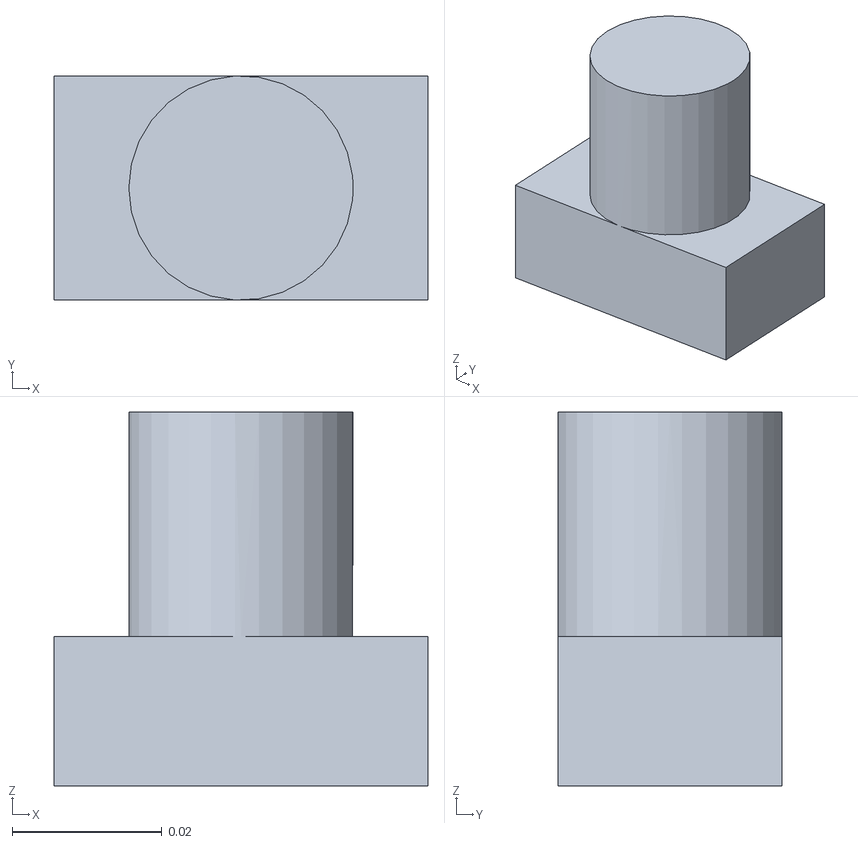
[picture p126: CAD file, 2025-09-30, last stored version]
Matlab/V2.1/V2_URDF/meshes/base_link.STL
0.05 x 0.03 x 0.05
