OsubuDc/Thesis/Matlab/V2.1/V2_URDF/meshes/EndEffector.STL

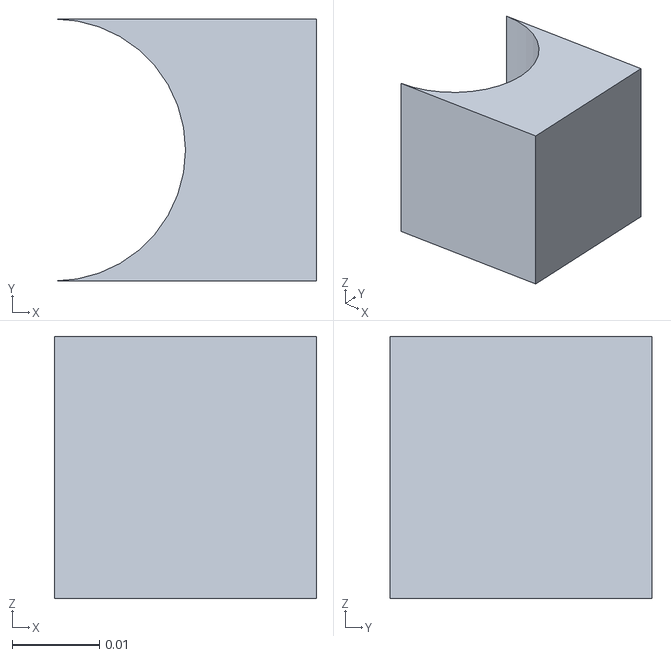
[picture p127: CAD file, 2025-09-30, last stored version]
Matlab/V2.1/V2_URDF/meshes/EndEffector.STL
0.03 x 0.03 x 0.03
