OsubuDc/Thesis/Matlab/V2.1/V2_URDF/meshes/Link1.STL

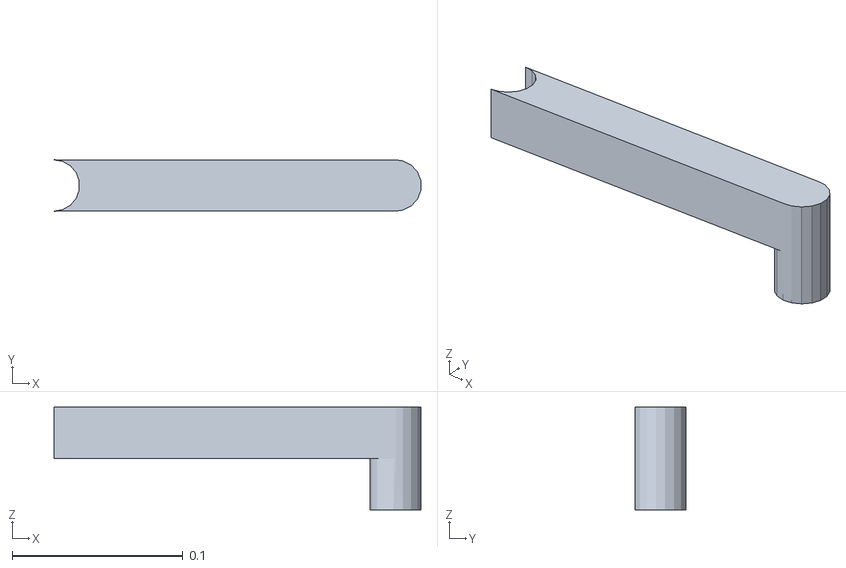
[picture p128: CAD file, 2025-09-30, last stored version]
Matlab/V2.1/V2_URDF/meshes/Link1.STL
0.215 x 0.03 x 0.06
