OsubuDc/Thesis/Matlab/V2/EndEffector_Default_sldprt.STEP

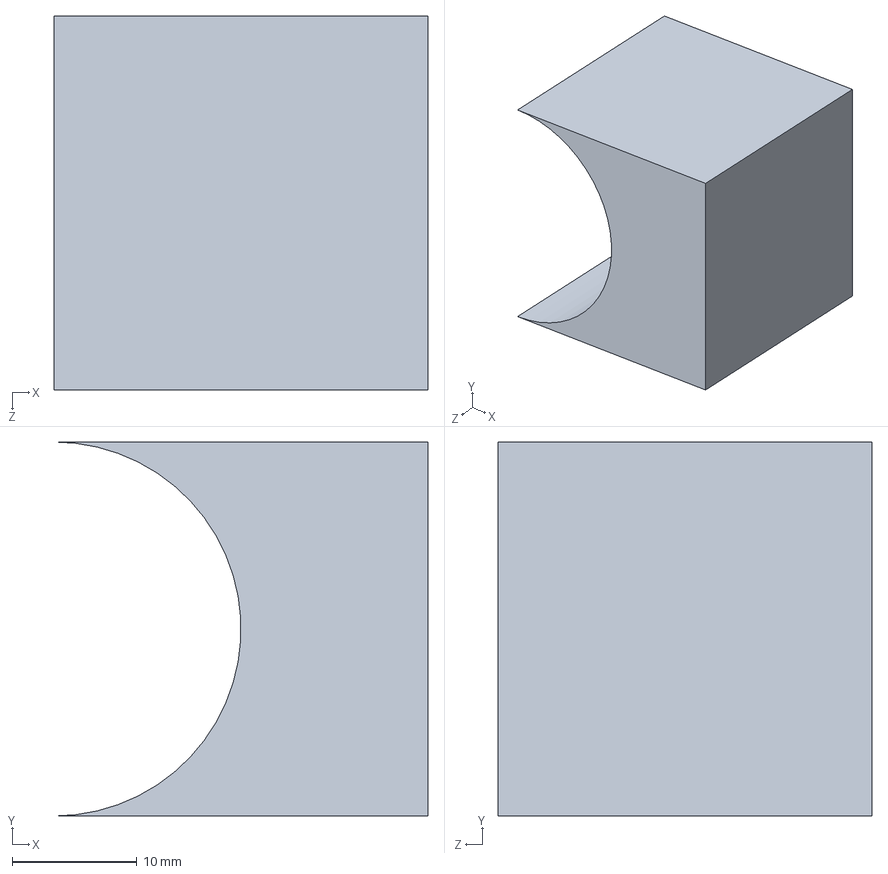
[picture p129: CAD file, 2025-09-30, an earlier design]
Matlab/V2/EndEffector_Default_sldprt.STEP
30.0 x 30.0 x 30.0 mm
