OsubuDc/Thesis/Matlab/V2/Link1_Default_sldprt.STEP

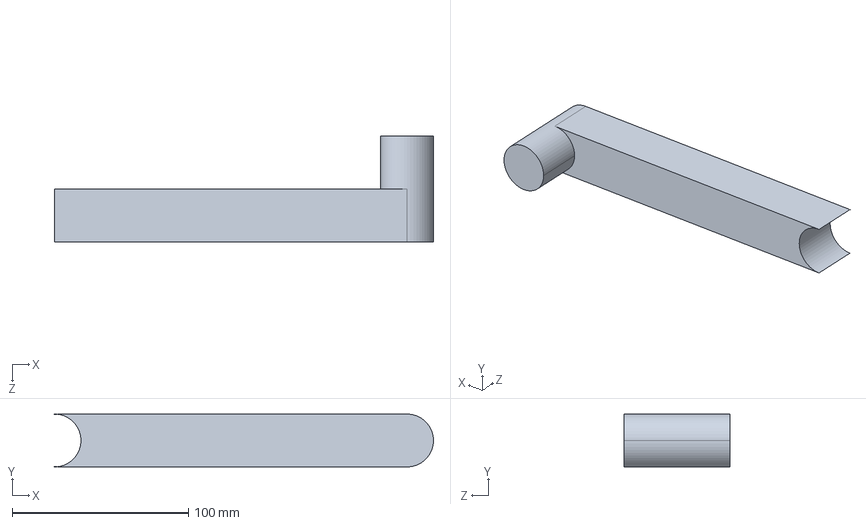
[picture p130: CAD file, 2025-09-30, an earlier design]
Matlab/V2/Link1_Default_sldprt.STEP
215.0 x 30.0 x 60.0 mm
