OsubuDc/Thesis/Matlab/V2/Link2_Default_sldprt.STEP

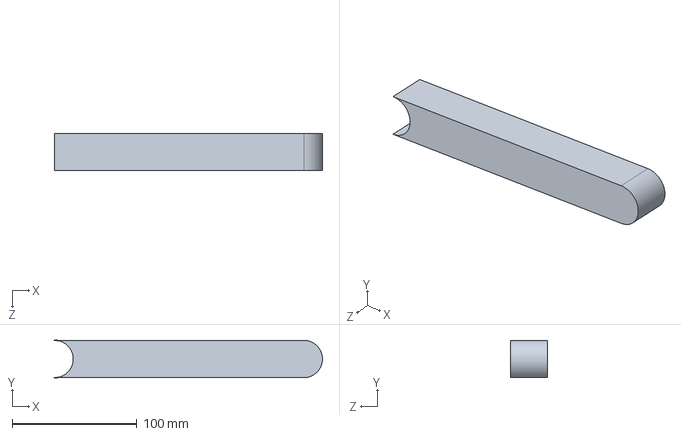
[picture p131: CAD file, 2025-09-30, an earlier design]
Matlab/V2/Link2_Default_sldprt.STEP
215.0 x 30.0 x 30.0 mm
