OsubuDc/Thesis/Matlab/V2/Base_Link_Default_sldprt.STEP

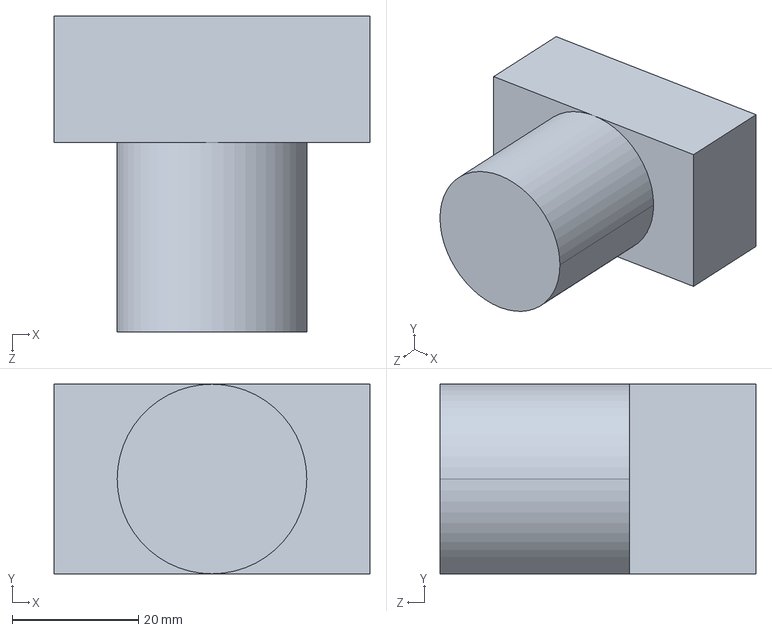
[picture p132: CAD file, 2025-09-30, an earlier design]
Matlab/V2/Base_Link_Default_sldprt.STEP
50.0 x 30.0 x 50.0 mm
