OsubuDc/Thesis/csv/test1_baseline.csv

time | q1 | q2 | q3 | v1 | v2 | v3 | qdd1 | qdd2 | qdd3 | u1 | u2 | u3 | damp1 | damp2 | damp3 | limit1 | limit2 | limit3 | total1 | total2 | total3 | ee_x | ee_y | ee_z | sp_x | sp_y | sp_z | spv_x | spv_y | spv_z
0.001000 | 0.000000 | 0.000000 | 0.000000 | 0.000000 | 0.000001 | 0.000799 | 0.000866 | 0.001784 | 0.773475 | -0.000015 | -0.174244 | -0.179489 | -0.000000 | -0.000000 | -0.000056 | 0.000000 | 0.000000 | 0.000000 | -0.000015 | -0.174244 | -0.179545 | 0.200000 | 0.000000 | 0.251500 | 0.200000 | 0.000000 | 0.250000 | 0.000000 | 0.000000 | 0.000000
0.002000 | 0.000000 | 0.000000 | 0.000002 | 0.000002 | 0.000004 | 0.001548 | 0.001664 | 0.003436 | 0.725098 | -0.000015 | -0.174257 | -0.179499 | -0.000000 | -0.000000 | -0.000108 | 0.000000 | 0.000000 | 0.000000 | -0.000015 | -0.174257 | -0.179608 | 0.200000 | 0.000000 | 0.251500 | 0.200000 | 0.000000 | 0.250000 | 0.000000 | 0.000000 | 0.000000
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
