OsubuDc/Thesis/csv/test1_baseline_kpkd.csv

time | q1 | q2 | q3 | v1 | v2 | v3 | qdd1 | qdd2 | qdd3 | u1 | u2 | u3 | damp1 | damp2 | damp3 | limit1 | limit2 | limit3 | total1 | total2 | total3 | ee_x | ee_y | ee_z | sp_x | sp_y | sp_z | spv_x | spv_y | spv_z
0.001000 | 0.000000 | 0.000000 | 0.000000 | 0.000000 | 0.000000 | 0.000073 | 0.000079 | 0.000163 | 0.070672 | -0.000001 | -0.175385 | -0.180444 | -0.000000 | -0.000000 | -0.000005 | 0.000000 | 0.000000 | 0.000000 | -0.000001 | -0.175385 | -0.180449 | 0.200000 | 0.000000 | 0.251500 | 0.200000 | 0.000000 | 0.250000 | 0.000000 | 0.000000 | 0.000000
0.002000 | 0.000000 | 0.000000 | 0.000000 | 0.000000 | 0.000000 | 0.000141 | 0.000153 | 0.000315 | 0.066595 | -0.000001 | -0.175385 | -0.180445 | -0.000000 | -0.000000 | -0.000010 | 0.000000 | 0.000000 | 0.000000 | -0.000001 | -0.175385 | -0.180455 | 0.200000 | 0.000000 | 0.251500 | 0.200000 | 0.000000 | 0.250000 | 0.000000 | 0.000000 | 0.000000
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
