OsubuDc/Thesis/Test 1: Trajectory Tracking.pdf

## Test 1: Baseline Trajectory Tracking

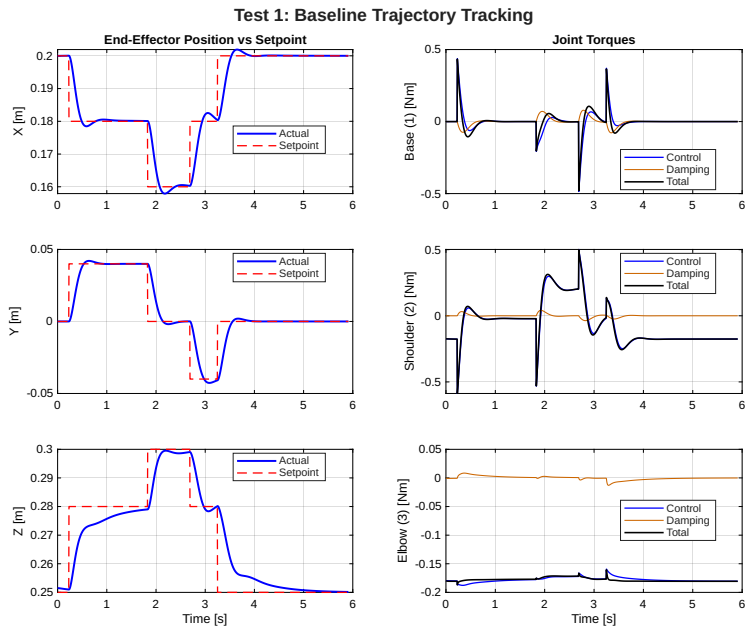
[picture p133: page 1]
Actual Setpoint; Time [s]; ase (1) [N; Joint Torques; Control Damping Total; Shoulder (2) [N; Elbo

End-Effector Position vs Setpoint

Actual Setpoint

Control
Damping Total
