OsubuDc/Thesis/ThesisV2/Graphics/sim_test1_tracking.pdf

## Test 1: Baseline Trajectory Tracking

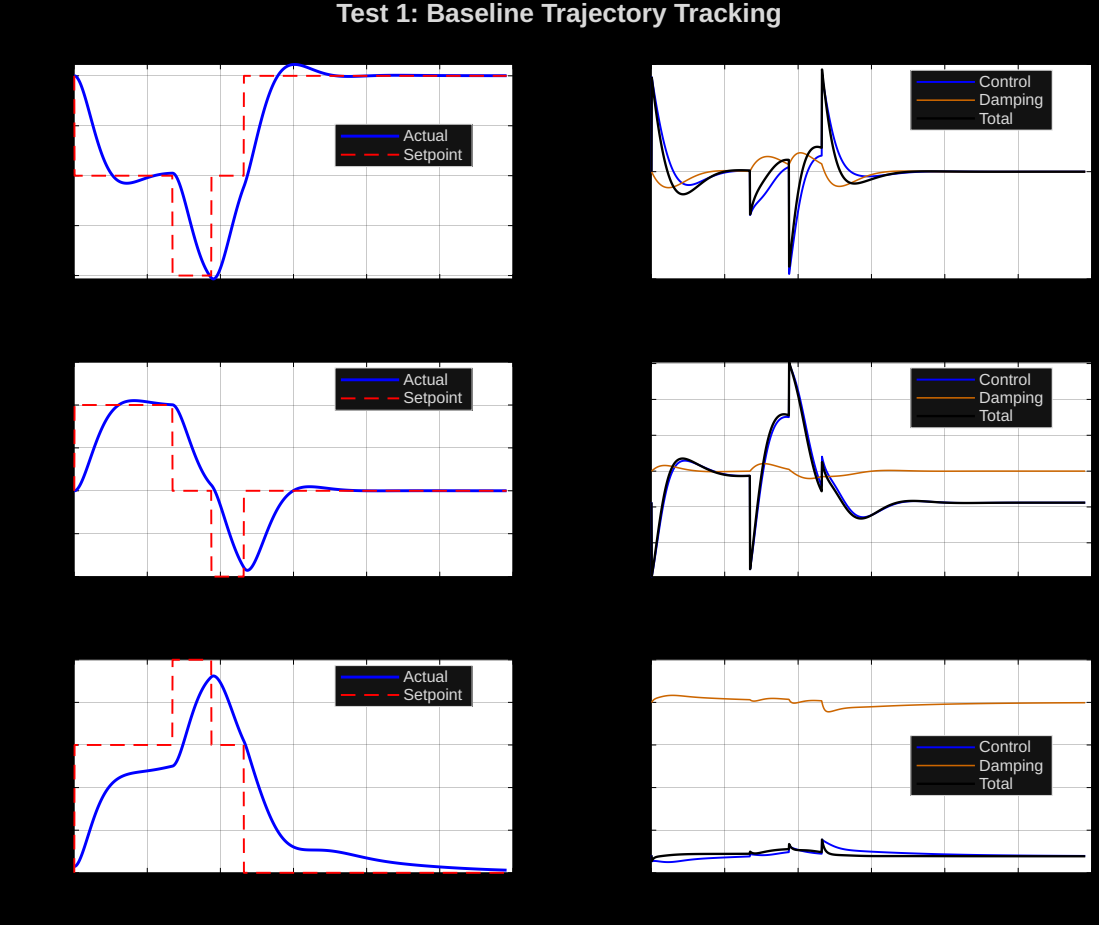
[picture p135: page 1]
Actual Setpoint; Time [s]; ase (1) [N; Joint Torques; Shoulder (2) [N; Control Damping Total; Elbo

End-Effector Position vs Setpoint

Control Damping Total

Actual Setpoint

Control
Damping Total
