OsubuDc/Thesis/ThesisV2/Graphics/sim_test1_3d.pdf

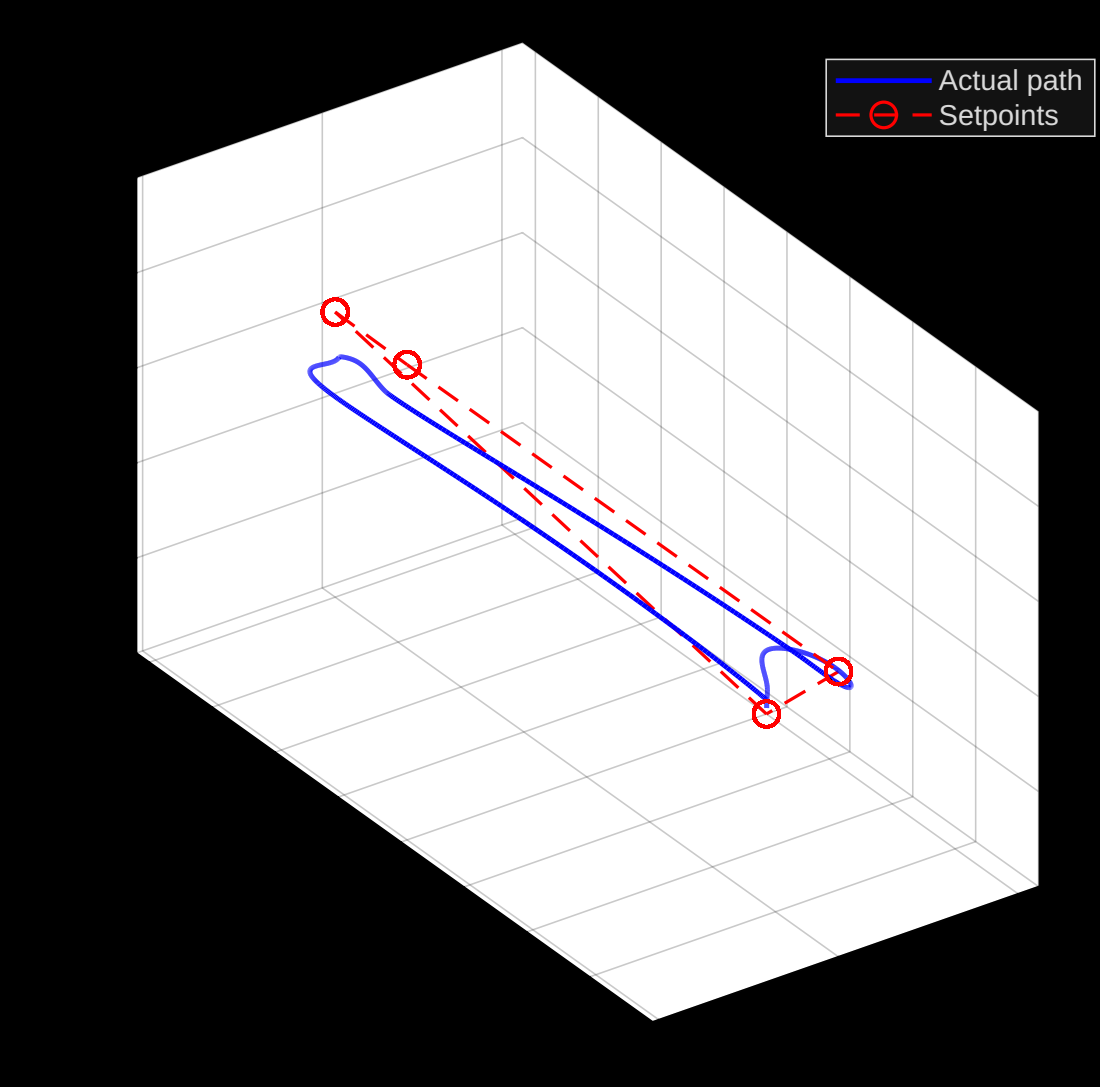
[picture p136: page 1]
Actual path Setpoints

End-Effector Trajectory (3D)
