OsubuDc/Thesis/(commit log)

2025-08-18 springtest/seafix - 19/08v1
2025-10-28 Sync local folder with GitHub
    [Base_Link_Default_sldprt.STEP, EndEffector.STL, EndEffector_Default_sldprt.STEP, Link1.STL, Link1_Default_sldprt.STEP, Link2.STL, Link2_Default_sldprt.STEP, V2_URDF.csv]
